RTimothyEdwards/sg13cmos5l_ocd_ip__biasgen/doc/sg13cmos5l_ocd_ip__bandgap.pdf

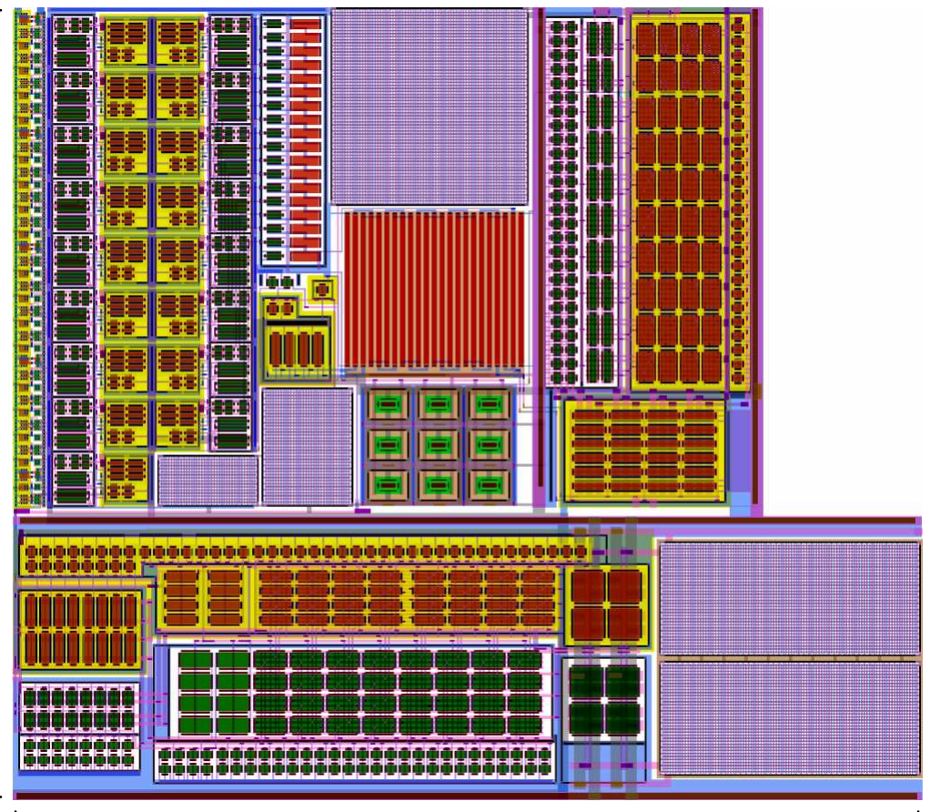
[picture p2: figure]

123µm

107µm

Circuit layout*

## sg13cmos5l_ocd_ip__bandgap

Bandgap voltage reference for IHP sg13cmos5l

Circuit description:

Pinout:
vdd
vss
dvdd
dvss
ena

vbg
trim
ibias1_250n
ibias2_1u

Analog power supply, nominally 3.3V Analog ground
Digital power supply, nominaly 1.2V Digital ground
Bandgap enable, digital (1.2V) domain
1 = enabled, 0 = disabled
Bandgap voltage output, nominally 1.2V
16−bit thermometer−encoded trim, digital (1.2V) domain. See table below
Bias current for bandgap, 250nA sink. Can be provided by the bias current generator in this repository. Bias current for output buffer, 1µA sink. Can be provided by the bias current generator in this repository.

Please note that the bias current generator circuit only stabilizes the current sources with the bandgap reference, while the current sinks are self−biased. The bandgap uses only current sinks to avoid a feedback loop with the current bias generator.

This is a standard bipolar bandgap reference circuit, with output trimmable by a 16−bit thermometer−encoded trim setting. The output is buffered by a follower amplifier.

vbg (nom.)

1.295V

1.231V

Note that this is a test version. It is based on the uncharacterized PNPMPA lateral bipolar, using the existing model from sg13g2. Once this circuit has been manufactured and tested, it will be re−trimmed to the correct nominal output.

trim trim[15:0]

1.184V0000000000000000
| 0000000000000001
| 0000000000000011
| 0000000000000111
| 0000000000001111
| 0000000000011111
| 0000000000111111
| 0000000001111111
| 0000000011111111
| 0000000111111111
| 0000001111111111
| 0000011111111111
| 0000111111111111
| 0001111111111111
| 0011111111111111
| 0111111111111111
| 1111111111111111

Also note: Future versions of this bandgap will replace the thermometer−encoded trim with a 4−bit binary trim input value.

*Note that there are different circuit layouts for the same device, with different aspect ratios.

1.188V
1.192V
1.198V
1.204V
1.211V
1.217V
1.224V

1.238V
1.246V
1.254V
1.261V
1.270V
1.278V
1.287V

Temperature coefficients
-40˚C to 125˚C: 35.78 ppm/˚C 0˚C to 85˚C: 21.58 ppm/˚C

## sg13cmos5l_ocd_ip__bandgap

Design: Theory of operation

This bandgap design was ported from a design for sky130 by Christoph Weiser. It is a standard voltage-mode bandgap reference, a variant of the Kuijk topology, with the output voltage taken directly from the drain of the pFET (feedback node).

The reference voltage is defined by

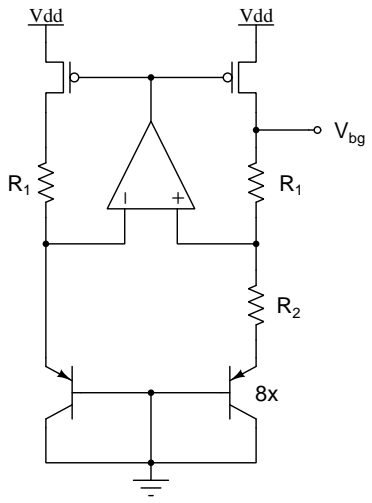
[picture p3: figure]
Vdd; Vbg

Vbg = VBE1 + (R1

/ R2

) ln(8) VT

In this layout, R1

= 394.5kΩ

The ratio of R2 to R1

is

The target current through the single bipolar is Itarget = 1.365µA By simulation, VBE1 at this current is 0.750 V.
VT at room temperature is 25.9mV.

The nominal R2

is therefore
R2

= VT

ln(8) / Itarget = 39.45kΩ

(1.25V - 0.75 V) / 53.85mV = 9.285

(Vbg - VBE1) / (VT

ln(8))

where 8 is the current ratio between the bipolars.

R2

is divided into a fixed and a variable (trimmable) component.

R2fixed = R1

/ 10 = 39.45kΩ
R2var (nominal) = (R1

/ 9.285) - R2fixed = 3.038kΩ

The variable resistance is made with a chain of 16 resistors, with each resistor shorted by a FET when the corresponding thermometer code bit is high. By simulation, the resistance of each FET is found to be 50Ω. The minimum resistance of R2var = 800Ω when all FETs are turned on and all resistors shorted. To make the centerpoint (half of the resistors shorted) be 3.038kΩ, the maximum resistance should be 5.274kΩ, and therefore each resistor should be (5,274 / 16 ≈ ) 330Ω.

Simulation shows the temperature response is flattest at approximately room temperature when the trim word is 0x00ff (half of the switches on, half off).
