RTimothyEdwards/sg13cmos5l_ocd_ip__biasgen/doc/bias_generator_fe.png

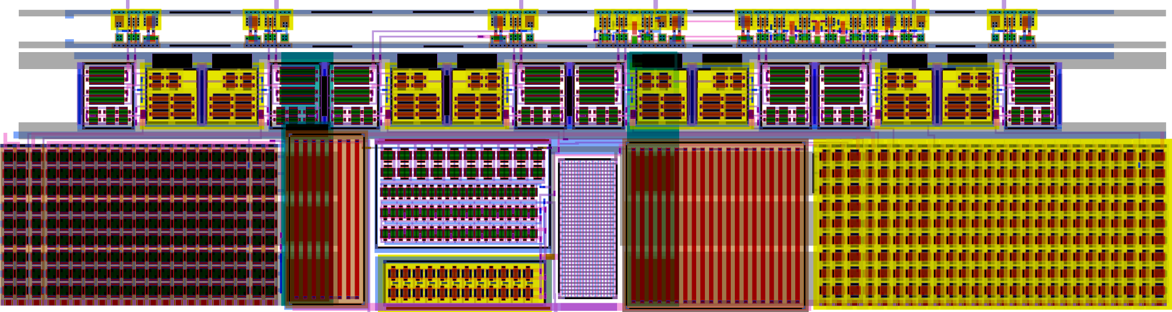
doc/bias_generator_fe.png
