RTimothyEdwards/sg13cmos5l_ocd_ip__biasgen/doc/sg13cmos5l_ocd_ip__bandgap.png

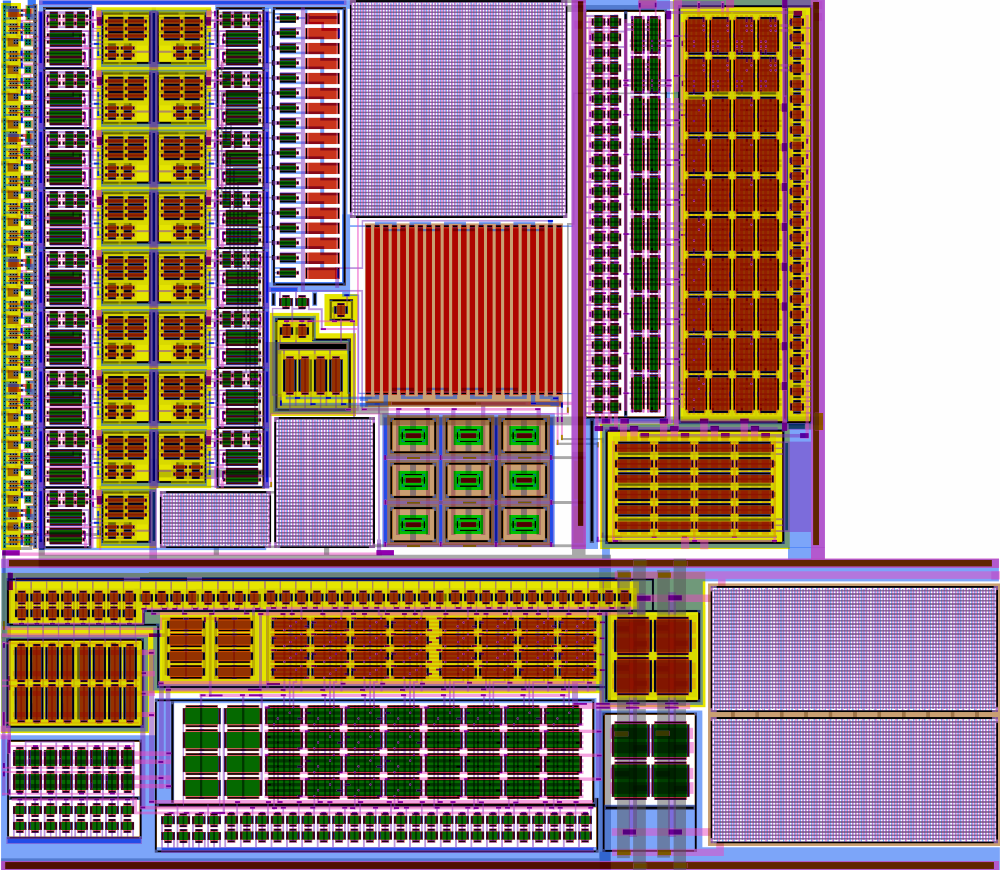
doc/sg13cmos5l_ocd_ip__bandgap.png
