RTimothyEdwards/sg13cmos5l_ocd_ip__biasgen/doc/sg13cmos5l_ocd_ip__voltgen.png

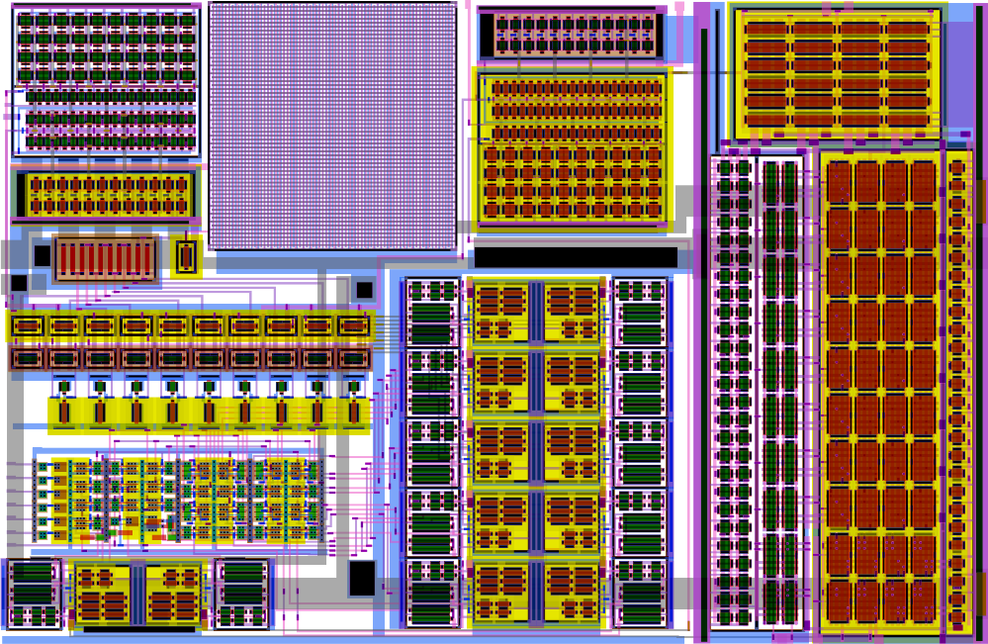
doc/sg13cmos5l_ocd_ip__voltgen.png
