RTimothyEdwards/sg13cmos5l_ocd_ip__biasgen/netlist/schematic/sg13cmos5l_ocd_ip__voltgen_v3.spice

** sch_path: /home/tim/gits/sg13cmos5l_ocd_chipalooza/dependencies/sg13cmos5l_ocd_ip__biasgen/xschem/sg13cmos5l_ocd_ip__voltgen_v3.sch
.subckt sg13cmos5l_ocd_ip__voltgen_v3 dvdd dvss vdd s[2] s[1] s[0] vbg vss ibias1u_1 vout_buf ibias1u_2 ena vout_unbuf ena1 ena2
+ high vgen_ena2_h
*.PININFO vdd:B vss:B vbg:I vout_unbuf:O ibias1u_1:B s[2:0]:I dvdd:B dvss:B ena:I vout_buf:O ibias1u_2:B ena1:I ena2:I high:I
*+ vgen_ena2_h:O
XM1 vref7 net22 vdd vdd sg13_hv_pmos w=2u l=0.5u ng=1 m=1 mm_ok=1
XR1 vref7 vref6 vss rhigh w=0.5e-6 l=2.5e-6 m=1 b=0 mm_ok=1
XR2 vref6 vref5 vss rhigh w=0.5e-6 l=2.5e-6 m=1 b=0 mm_ok=1
XR3 vref5 vref4 vss rhigh w=0.5e-6 l=2.5e-6 m=1 b=0 mm_ok=1
XR4 vref4 vref3 vss rhigh w=0.5e-6 l=2.5e-6 m=1 b=0 mm_ok=1
XR5 vref3 vref2 vss rhigh w=0.5e-6 l=2.5e-6 m=1 b=0 mm_ok=1
XR6 vref2 vref1 vss rhigh w=0.5e-6 l=2.5e-6 m=1 b=0 mm_ok=1
XR7 vref1 vref0 vss rhigh w=0.5e-6 l=2.5e-6 m=1 b=0 mm_ok=1
XR8 vref0 vss vss rhigh w=0.5e-6 l=2.5e-6 m=1 b=0 mm_ok=1
x2 v7b vdd vref7 vout_unbuf vss v7 xgate
x3 vdd v0 v0b vss hv_inv_1
x4 v6b vdd vref6 vout_unbuf vss v6 xgate
x5 v5b vdd vref5 vout_unbuf vss v5 xgate
x6 v4b vdd vref4 vout_unbuf vss v4 xgate
x7 v3b vdd vref3 vout_unbuf vss v3 xgate
x8 v2b vdd vref2 vout_unbuf vss v2 xgate
x9 v1b vdd vref1 vout_unbuf vss v1 xgate
x10 v0b vdd vref0 vout_unbuf vss v0 xgate
x11 net2 net1 v0 vdd vss level_shift
x12 net1 net2 dvdd dvss sg13cmos5l_inv_2
x13 net2 s2b s1b s0b dvdd dvss sg13cmos5l_nand3_1
x14 s0b s[0] dvdd dvss sg13cmos5l_inv_2
x15 s1b s[1] dvdd dvss sg13cmos5l_inv_2
x16 s2b s[2] dvdd dvss sg13cmos5l_inv_2
x17 s0 s0b dvdd dvss sg13cmos5l_inv_2
x18 s1 s1b dvdd dvss sg13cmos5l_inv_2
x19 s2 s2b dvdd dvss sg13cmos5l_inv_2
x20 vdd v1 v1b vss hv_inv_1
x21 net4 net3 v1 vdd vss level_shift
x22 net3 net4 dvdd dvss sg13cmos5l_inv_2
x23 net4 s2b s1b s0 dvdd dvss sg13cmos5l_nand3_1
x24 vdd v2 v2b vss hv_inv_1
x25 net6 net5 v2 vdd vss level_shift
x26 net5 net6 dvdd dvss sg13cmos5l_inv_2
x27 net6 s2b s1 s0b dvdd dvss sg13cmos5l_nand3_1
x28 vdd v3 v3b vss hv_inv_1
x29 net8 net7 v3 vdd vss level_shift
x30 net7 net8 dvdd dvss sg13cmos5l_inv_2
x31 net8 s2b s1 s0 dvdd dvss sg13cmos5l_nand3_1
x32 vdd v4 v4b vss hv_inv_1
x33 net10 net9 v4 vdd vss level_shift
x34 net9 net10 dvdd dvss sg13cmos5l_inv_2
x35 net10 s2 s1b s0b dvdd dvss sg13cmos5l_nand3_1
x36 vdd v5 v5b vss hv_inv_1
x37 net12 net11 v5 vdd vss level_shift
x38 net11 net12 dvdd dvss sg13cmos5l_inv_2
x39 net12 s2 s1b s0 dvdd dvss sg13cmos5l_nand3_1
x40 vdd v6 v6b vss hv_inv_1
x41 net14 net13 v6 vdd vss level_shift
x42 net13 net14 dvdd dvss sg13cmos5l_inv_2
x43 net14 s2 s1 s0b dvdd dvss sg13cmos5l_nand3_1
x44 vdd v7 v7b vss hv_inv_1
x45 net16 net15 v7 vdd vss level_shift
x46 net15 net16 dvdd dvss sg13cmos5l_inv_2
x47 net16 s2 s1 s0 dvdd dvss sg13cmos5l_nand3_1
x1 net18 ena vgen_ena_h vdd vss level_shift
x51 net18 ena dvdd dvss sg13cmos5l_inv_2
x48 vdd net22 vbg net17 ibias1u_1 vss vgen_ena_h n_amp_large
x52 vdd vout_buf vout_unbuf vout_buf vss ibias1u_2 vgen_ena1_h se_folded_cascode_p
x49 net19 ena1 vgen_ena1_h vdd vss level_shift
x53 net19 ena1 dvdd dvss sg13cmos5l_inv_2
x54 net20 ena2 vgen_ena2_h vdd vss level_shift
x55 net20 ena2 dvdd dvss sg13cmos5l_inv_2
x56 high_h vdd net17 vref3 vss low_h xgate
x57 low_h vdd net17 vref2 vss high_h xgate
x58 net21 high high_h vdd vss level_shift
x59 net21 high dvdd dvss sg13cmos5l_inv_2
x60 vdd high_h low_h vss hv_inv_1
XR9 vss vss vss rhigh w=0.5e-6 l=2.5e-6 m=1 b=0 mm_ok=1
XR10 vss vss vss rhigh w=0.5e-6 l=2.5e-6 m=1 b=0 mm_ok=1
x67 s[0] dvdd dvss sg13cmos5l_antennanp
x68 dvdd dvss sg13cmos5l_decap_4
x61 s[1] dvdd dvss sg13cmos5l_antennanp
x62 s[2] dvdd dvss sg13cmos5l_antennanp
x63 high dvdd dvss sg13cmos5l_antennanp
x64 ena dvdd dvss sg13cmos5l_antennanp
x65 ena1 dvdd dvss sg13cmos5l_antennanp
x66 ena2 dvdd dvss sg13cmos5l_antennanp
XC4 vdd net22 cap_cmomf w=15e-6 l=23e-6 mmin=1 mmax=4 subblock=0 m=1 mm_ok=1
XC5 vdd net22 cap_cmomf w=26.26e-6 l=26.26e-6 mmin=1 mmax=4 subblock=0 m=1 mm_ok=1
XC6 vdd net22 cap_cmomf w=8e-6 l=23e-6 mmin=1 mmax=4 subblock=0 m=1 mm_ok=1
.ends

* expanding   symbol:  xgate.sym # of pins=6
** sym_path: /home/tim/gits/sg13cmos5l_ocd_chipalooza/dependencies/sg13cmos5l_ocd_ip__biasgen/xschem/xgate.sym
** sch_path: /home/tim/gits/sg13cmos5l_ocd_chipalooza/dependencies/sg13cmos5l_ocd_ip__biasgen/xschem/xgate.sch
.subckt xgate ena_b vdd in out vss ena
*.PININFO out:B in:B vdd:B vss:B ena_b:I ena:I
XM1 in ena_b out vdd sg13_hv_pmos w=2u l=0.5u ng=1 m=1 mm_ok=1
XM2 in ena out vss sg13_hv_nmos w=2u l=0.5u ng=1 m=1 mm_ok=1
.ends


* expanding   symbol:  hv_inv_1.sym # of pins=4
** sym_path: /home/tim/gits/sg13cmos5l_ocd_chipalooza/dependencies/sg13cmos5l_ocd_ip__biasgen/xschem/hv_inv_1.sym
** sch_path: /home/tim/gits/sg13cmos5l_ocd_chipalooza/dependencies/sg13cmos5l_ocd_ip__biasgen/xschem/hv_inv_1.sch
.subckt hv_inv_1 vdd A X vss
*.PININFO A:I vdd:B vss:B X:O
XM1 X A vdd vdd sg13_hv_pmos w=2.0u l=0.4u ng=1 m=1 mm_ok=1
XM2 X A vss vss sg13_hv_nmos w=1.0u l=0.45u ng=1 m=1 mm_ok=1
.ends


* expanding   symbol:  level_shift.sym # of pins=3
** sym_path: /home/tim/gits/sg13cmos5l_ocd_chipalooza/dependencies/sg13cmos5l_ocd_ip__biasgen/xschem/level_shift.sym
** sch_path: /home/tim/gits/sg13cmos5l_ocd_chipalooza/dependencies/sg13cmos5l_ocd_ip__biasgen/xschem/level_shift.sch
.subckt level_shift in_n in_p out vdd vss
*.PININFO in_n:I in_p:I out:O
XM1 net1 in_p vss vss sg13_hv_nmos w=4u l=0.5u ng=1 m=2 mm_ok=1
XM2 net1 S1_N vdd vdd sg13_hv_pmos w=1u l=0.5u ng=1 m=2 mm_ok=1
XM3 S1_N in_n vss vss sg13_hv_nmos w=4u l=0.5u ng=1 m=2 mm_ok=1
XM4 S1_N net1 vdd vdd sg13_hv_pmos w=1u l=0.5u ng=1 m=2 mm_ok=1
XM5 S2_N S1_N vdd vdd sg13_hv_pmos w=2u l=0.5u ng=1 m=2 mm_ok=1
XM6 S2_N S1_N vss vss sg13_hv_nmos w=1u l=0.5u ng=1 m=2 mm_ok=1
XM7 out S2_N vdd vdd sg13_hv_pmos w=2u l=0.5u ng=1 m=4 mm_ok=1
XM8 out S2_N vss vss sg13_hv_nmos w=1u l=0.5u ng=1 m=4 mm_ok=1
.ends


* expanding   symbol:  n_amp_large.sym # of pins=7
** sym_path: /home/tim/gits/sg13cmos5l_ocd_chipalooza/dependencies/sg13cmos5l_ocd_ip__biasgen/xschem/n_amp_large.sym
** sch_path: /home/tim/gits/sg13cmos5l_ocd_chipalooza/dependencies/sg13cmos5l_ocd_ip__biasgen/xschem/n_amp_large.sch
.subckt n_amp_large avdd out inn inp ibias avss ena
*.PININFO inp:I inn:I out:O avdd:B avss:B ena:I ibias:B
XM1 vcom net1 avss avss sg13_hv_nmos w=20u l=1u ng=20 m=1 mm_ok=1
XM2 out outn avdd avdd sg13_hv_pmos w=10u l=0.5u ng=10 m=1 mm_ok=1
XM3 outn outn avdd avdd sg13_hv_pmos w=10u l=0.5u ng=10 m=1 mm_ok=1
XM4 outn inp vcom avss sg13_hv_nmos w=20u l=0.5u ng=20 m=1 mm_ok=1
XM5 out inn vcom avss sg13_hv_nmos w=20u l=0.5u ng=20 m=1 mm_ok=1
XM6 ibias ena net1 avss sg13_hv_nmos w=20u l=0.5u ng=20 m=1 mm_ok=1
XM7 net1 net1 avss avss sg13_hv_nmos w=20u l=1u ng=20 m=1 mm_ok=1
XM8 avdd avdd avdd avdd sg13_hv_pmos w=2u l=0.5u ng=2 m=2 mm_ok=1
.ends


* expanding   symbol:  se_folded_cascode_p.sym # of pins=7
** sym_path: /home/tim/gits/sg13cmos5l_ocd_chipalooza/dependencies/sg13cmos5l_ocd_ip__biasgen/xschem/se_folded_cascode_p.sym
** sch_path: /home/tim/gits/sg13cmos5l_ocd_chipalooza/dependencies/sg13cmos5l_ocd_ip__biasgen/xschem/se_folded_cascode_p.sch
.subckt se_folded_cascode_p vdd out inp inn vss bias ena
*.PININFO inn:I inp:I out:O bias:B vdd:B vss:B ena:I
XM3 out1p inn diff vdd sg13_hv_pmos w=4u l=1u ng=1 m=8 mm_ok=1
XM2 out1n inp diff vdd sg13_hv_pmos w=4u l=1u ng=1 m=8 mm_ok=1
XM1 diff vbp1 vdd vdd sg13_hv_pmos w=1u l=1u ng=1 m=16 mm_ok=1
XM4 out1n vbn1 vss vss sg13_hv_nmos w=1u l=1u ng=1 m=16 mm_ok=1
XM5 out1p vbn1 vss vss sg13_hv_nmos w=1u l=1u ng=1 m=16 mm_ok=1
XM6 mirr vbn2 out1n vss sg13_hv_nmos w=1u l=4u ng=1 m=8 mm_ok=1
XM7 out vbn2 out1p vss sg13_hv_nmos w=1u l=4u ng=1 m=8 mm_ok=1
XM8 mirr bias nd10 vdd sg13_hv_pmos w=2u l=4u ng=1 m=8 mm_ok=1
XM9 out bias nd11 vdd sg13_hv_pmos w=2u l=4u ng=1 m=8 mm_ok=1
XM10 nd10 mirr vdd vdd sg13_hv_pmos w=2u l=4u ng=1 m=8 mm_ok=1
XM11 nd11 mirr vdd vdd sg13_hv_pmos w=2u l=4u ng=1 m=8 mm_ok=1
XMB1 bias bias vbp1 vdd sg13_hv_pmos w=2u l=4u ng=1 m=4 mm_ok=1
XMB2 vbp1 vbp1 vdd vdd sg13_hv_pmos w=1u l=1u ng=1 m=4 mm_ok=1
XMB3 vbn2 vbp1 vdd vdd sg13_hv_pmos w=1u l=1u ng=1 m=4 mm_ok=1
XMB4 vbn2 vbn2 vbn1 vss sg13_hv_nmos w=1u l=4u ng=1 m=4 mm_ok=1
XMB5 vbn1 vbn1 vss vss sg13_hv_nmos w=1u l=1u ng=1 m=4 mm_ok=1
XMB6 bias ena vdd vdd sg13_hv_pmos w=1u l=1u ng=1 m=1 mm_ok=1
XM12 vdd vdd vdd vdd sg13_hv_pmos w=4u l=1u ng=1 m=8 mm_ok=1
XM13 vdd vdd vdd vdd sg13_hv_pmos w=1u l=1u ng=1 m=1 mm_ok=1
XMB7 vss vss vss vss sg13_hv_nmos w=1u l=1u ng=1 m=16 mm_ok=1
XMB8 vdd vdd vdd vdd sg13_hv_pmos w=2u l=4u ng=1 m=4 mm_ok=1
.ends
