RTimothyEdwards/sg13cmos5l_ocd_ip__biasgen/netlist/schematic/sg13cmos5l_ocd_ip__biasgen1.spice

** sch_path: /home/tim/gits/sg13cmos5l_ocd_chipalooza/dependencies/sg13cmos5l_ocd_ip__biasgen/xschem/sg13cmos5l_ocd_ip__biasgen1.sch
.subckt sg13cmos5l_ocd_ip__biasgen1 ena avdd avss ref_in dvdd vbg ref_sel_vbg dvss bandgap_source_ibias bandgap_source[4]
+ bandgap_source[3] bandgap_source[2] bandgap_source[1] bandgap_source[0] bandgap_sink[4] bandgap_sink[3] bandgap_sink[2] bandgap_sink[1]
+ bandgap_sink[0] voltgen_source1[4] voltgen_source1[3] voltgen_source1[2] voltgen_source1[1] voltgen_source1[0] bandgap_sink_ibias
+ voltgen_source2[4] voltgen_source2[3] voltgen_source2[2] voltgen_source2[1] voltgen_source2[0] voltgen_sink[4] voltgen_sink[3] voltgen_sink[2]
+ voltgen_sink[1] voltgen_sink[0] voltgen_source1_ibias test_sink[4] test_sink[3] test_sink[2] test_sink[1] test_sink[0] voltgen_source2_ibias
+ idac1_source[7] idac1_source[6] idac1_source[5] idac1_source[4] idac1_source[3] idac1_source[2] idac1_source[1] idac1_source[0]
+ voltgen_sink_ibias test_sink_ibias idac1_source idac2_source idac1_sink[7] idac1_sink[6] idac1_sink[5] idac1_sink[4] idac1_sink[3] idac1_sink[2]
+ idac1_sink[1] idac1_sink[0] idac2_source[7] idac2_source[6] idac2_source[5] idac2_source[4] idac2_source[3] idac2_source[2] idac2_source[1]
+ idac2_source[0] idac2_sink[7] idac2_sink[6] idac2_sink[5] idac2_sink[4] idac2_sink[3] idac2_sink[2] idac2_sink[1] idac2_sink[0] idac1_sink
+ idac2_sink ref_sel_coarse ref_sel_fine
*.PININFO avdd:B avss:B dvdd:B dvss:B ena:I ref_in:I vbg:I ref_sel_vbg:I bandgap_sink[4:0]:I voltgen_sink[4:0]:I test_sink[4:0]:I
*+ idac1_sink[7:0]:I idac2_sink[7:0]:I bandgap_sink_ibias:B voltgen_sink_ibias:B test_sink_ibias:B idac1_sink:B idac2_sink:B ref_sel_fine:I
*+ ref_sel_coarse:I bandgap_source_ibias:B voltgen_source1_ibias:B voltgen_source2_ibias:B idac1_source:B idac2_source:B bandgap_source[4:0]:I
*+ voltgen_source1[4:0]:I voltgen_source2[4:0]:I idac1_source[7:0]:I idac2_source[7:0]:I
x1 avdd ena vbg net1 avss dvdd dvss ref_sel_vbg ref_in dvss nbias pcasc pbias net2 dvss ncasc ref_sel_fine ref_sel_coarse avdd
+ bias_generator_fe
* noconn #net1
* noconn #net2
x12 dvdd dvss avdd nbias avss bandgap_sink[4] bandgap_sink[3] bandgap_sink[2] bandgap_sink[1] bandgap_sink[0] bandgap_sink_ibias
+ ncasc avss avss bias_generator_be0n
x13 dvdd dvss avdd pcasc pbias bandgap_source[4] bandgap_source[3] bandgap_source[2] bandgap_source[1] bandgap_source[0]
+ bandgap_source_ibias avss avdd avdd avdd bias_generator_be0p
x14 dvdd dvss avdd nbias avss idac1_sink[7] idac1_sink[6] idac1_sink[5] idac1_sink[4] idac1_sink[3] idac1_sink[2] idac1_sink[1]
+ idac1_sink[0] idac1_sink ncasc avss avss bias_generator_be1n
x15 dvdd dvss avdd pcasc pbias idac2_source[7] idac2_source[6] idac2_source[5] idac2_source[4] idac2_source[3] idac2_source[2]
+ idac2_source[1] idac2_source[0] idac2_source avss avdd avdd avdd bias_generator_be1p
x2 dvdd dvss avdd nbias avss voltgen_sink[4] voltgen_sink[3] voltgen_sink[2] voltgen_sink[1] voltgen_sink[0] voltgen_sink_ibias
+ ncasc avss avss bias_generator_be0n
x4 dvdd dvss avdd nbias avss test_sink[4] test_sink[3] test_sink[2] test_sink[1] test_sink[0] test_sink_ibias ncasc avss avss
+ bias_generator_be0n
x3 dvdd dvss avdd nbias avss idac2_sink[7] idac2_sink[6] idac2_sink[5] idac2_sink[4] idac2_sink[3] idac2_sink[2] idac2_sink[1]
+ idac2_sink[0] idac2_sink ncasc avss avss bias_generator_be1n
x5 dvdd dvss avdd pcasc pbias voltgen_source1[4] voltgen_source1[3] voltgen_source1[2] voltgen_source1[1] voltgen_source1[0]
+ voltgen_source1_ibias avss avdd avdd avdd bias_generator_be0p
x6 dvdd dvss avdd pcasc pbias voltgen_source2[4] voltgen_source2[3] voltgen_source2[2] voltgen_source2[1] voltgen_source2[0]
+ voltgen_source2_ibias avss avdd avdd avdd bias_generator_be0p
x7 dvdd dvss avdd pcasc pbias idac1_source[7] idac1_source[6] idac1_source[5] idac1_source[4] idac1_source[3] idac1_source[2]
+ idac1_source[1] idac1_source[0] idac1_source avss avdd avdd avdd bias_generator_be1p
x8[11] net4 avss ncasc nbias avss avss avss bias_nstack
x8[10] net4 avss ncasc nbias avss avss avss bias_nstack
x8[9] net4 avss ncasc nbias avss avss avss bias_nstack
x8[8] net4 avss ncasc nbias avss avss avss bias_nstack
x8[7] net4 avss ncasc nbias avss avss avss bias_nstack
x8[6] net4 avss ncasc nbias avss avss avss bias_nstack
x8[5] net4 avss ncasc nbias avss avss avss bias_nstack
x8[4] net4 avss ncasc nbias avss avss avss bias_nstack
x8[3] net4 avss ncasc nbias avss avss avss bias_nstack
x8[2] net4 avss ncasc nbias avss avss avss bias_nstack
x8[1] net4 avss ncasc nbias avss avss avss bias_nstack
x8[0] net4 avss ncasc nbias avss avss avss bias_nstack
x9[11] avdd pbias pcasc avdd net3 avdd avdd bias_pstack
x9[10] avdd pbias pcasc avdd net3 avdd avdd bias_pstack
x9[9] avdd pbias pcasc avdd net3 avdd avdd bias_pstack
x9[8] avdd pbias pcasc avdd net3 avdd avdd bias_pstack
x9[7] avdd pbias pcasc avdd net3 avdd avdd bias_pstack
x9[6] avdd pbias pcasc avdd net3 avdd avdd bias_pstack
x9[5] avdd pbias pcasc avdd net3 avdd avdd bias_pstack
x9[4] avdd pbias pcasc avdd net3 avdd avdd bias_pstack
x9[3] avdd pbias pcasc avdd net3 avdd avdd bias_pstack
x9[2] avdd pbias pcasc avdd net3 avdd avdd bias_pstack
x9[1] avdd pbias pcasc avdd net3 avdd avdd bias_pstack
x9[0] avdd pbias pcasc avdd net3 avdd avdd bias_pstack
* noconn #net4
* noconn #net3
.ends

* expanding   symbol:  bias_generator_fe.sym # of pins=19
** sym_path: /home/tim/gits/sg13cmos5l_ocd_chipalooza/dependencies/sg13cmos5l_ocd_ip__biasgen/xschem/bias_generator_fe.sym
** sch_path: /home/tim/gits/sg13cmos5l_ocd_chipalooza/dependencies/sg13cmos5l_ocd_ip__biasgen/xschem/bias_generator_fe.sch
.subckt bias_generator_fe avdd ena vbg src_test0 avss dvdd ena_src_test0 ref_sel_vbg ref_in dvss nbias pcasc pbias snk_test0
+ ena_snk_test0 ncasc ref_sel_fine ref_sel_coarse shld2
*.PININFO ref_in:I avss:B ref_sel_vbg:I avdd:B ena_src_test0:I ena_snk_test0:I src_test0:B snk_test0:B vbg:I ena:I dvdd:B dvss:B
*+ pcasc:O pbias:O nbias:O ncasc:O ref_sel_fine:I ref_sel_coarse:I shld2:B
XR4 ref_in net7 avss rhigh w=0.5u l=138.57u m=1 b=0 mm_ok=1
x4 net1 ena_3v3 ncasc nbias avss avss avss bias_nstack
x13[1] avdd pbias pcasc enb_test0_3v3 src_test0 shld2 avdd bias_pstack
x13[0] avdd pbias pcasc enb_test0_3v3 src_test0 shld2 avdd bias_pstack
x17[1] snk_test0 ena_test0_3v3 ncasc nbias avss avss avss bias_nstack
x17[0] snk_test0 ena_test0_3v3 ncasc nbias avss avss avss bias_nstack
x1 ref_sel_vbg net2 enb_vbg_3v3 avdd avss level_shift
x11 net5 ena_snk_test0 ena_test0_3v3 avdd avss level_shift
x23 ena_src_test0 net4 enb_test0_3v3 avdd avss level_shift
x24 net3 ena dvdd dvss sg13cmos5l_inv_2
x35 net2 ref_sel_vbg dvdd dvss sg13cmos5l_inv_2
XR1 net10 avss avss rhigh w=0.5u l=337.14u m=1 b=0 mm_ok=1
x36 net3 ena ena_3v3 avdd avss level_shift
Vmeas vfb net10 0
.save i(vmeas)
x19[2] avdd pbias pcasc enb_std_3v3 vfb shld2 avdd bias_pstack
x19[1] avdd pbias pcasc enb_std_3v3 vfb shld2 avdd bias_pstack
x19[0] avdd pbias pcasc enb_std_3v3 vfb shld2 avdd bias_pstack
x5[6] dvdd dvss sg13cmos5l_decap_4
x5[5] dvdd dvss sg13cmos5l_decap_4
x5[4] dvdd dvss sg13cmos5l_decap_4
x5[3] dvdd dvss sg13cmos5l_decap_4
x5[2] dvdd dvss sg13cmos5l_decap_4
x5[1] dvdd dvss sg13cmos5l_decap_4
x5[0] dvdd dvss sg13cmos5l_decap_4
x5 ref_sel_vbg dvdd dvss sg13cmos5l_antennanp
x6 ena dvdd dvss sg13cmos5l_antennanp
x7 ena_src_test0 dvdd dvss sg13cmos5l_antennanp
x8 ena_snk_test0 dvdd dvss sg13cmos5l_antennanp
x9 net4 ena_src_test0 dvdd dvss sg13cmos5l_inv_2
x10 net5 ena_snk_test0 dvdd dvss sg13cmos5l_inv_2
x12 net2 ref_sel_vbg ena_vbg_3v3 avdd avss level_shift
x1[15] nset ena_3v3 ncasc nbias avss avss avss bias_nset
x1[14] nset ena_3v3 ncasc nbias avss avss avss bias_nset
x1[13] nset ena_3v3 ncasc nbias avss avss avss bias_nset
x1[12] nset ena_3v3 ncasc nbias avss avss avss bias_nset
x1[11] nset ena_3v3 ncasc nbias avss avss avss bias_nset
x1[10] nset ena_3v3 ncasc nbias avss avss avss bias_nset
x1[9] nset ena_3v3 ncasc nbias avss avss avss bias_nset
x1[8] nset ena_3v3 ncasc nbias avss avss avss bias_nset
x1[7] nset ena_3v3 ncasc nbias avss avss avss bias_nset
x1[6] nset ena_3v3 ncasc nbias avss avss avss bias_nset
x1[5] nset ena_3v3 ncasc nbias avss avss avss bias_nset
x1[4] nset ena_3v3 ncasc nbias avss avss avss bias_nset
x1[3] nset ena_3v3 ncasc nbias avss avss avss bias_nset
x1[2] nset ena_3v3 ncasc nbias avss avss avss bias_nset
x1[1] nset ena_3v3 ncasc nbias avss avss avss bias_nset
x1[0] nset ena_3v3 ncasc nbias avss avss avss bias_nset
x14 avdd pbias pcasc ena_vbg_3v3 net6 avdd bias_pset
Vmeas1 net7 nset 0
.save i(vmeas1)
Vmeas2 net6 net1 0
.save i(vmeas2)
x3 avdd pbias vbg vfb nbias avss ena_vbg_3v3 bias_amp_large
x2[15] avdd pbias pcasc enb_fine_3v3 vfb shld2 avdd bias_pstack
x2[14] avdd pbias pcasc enb_fine_3v3 vfb shld2 avdd bias_pstack
x2[13] avdd pbias pcasc enb_fine_3v3 vfb shld2 avdd bias_pstack
x2[12] avdd pbias pcasc enb_fine_3v3 vfb shld2 avdd bias_pstack
x2[11] avdd pbias pcasc enb_fine_3v3 vfb shld2 avdd bias_pstack
x2[10] avdd pbias pcasc enb_fine_3v3 vfb shld2 avdd bias_pstack
x2[9] avdd pbias pcasc enb_fine_3v3 vfb shld2 avdd bias_pstack
x2[8] avdd pbias pcasc enb_fine_3v3 vfb shld2 avdd bias_pstack
x2[7] avdd pbias pcasc enb_fine_3v3 vfb shld2 avdd bias_pstack
x2[6] avdd pbias pcasc enb_fine_3v3 vfb shld2 avdd bias_pstack
x2[5] avdd pbias pcasc enb_fine_3v3 vfb shld2 avdd bias_pstack
x2[4] avdd pbias pcasc enb_fine_3v3 vfb shld2 avdd bias_pstack
x2[3] avdd pbias pcasc enb_fine_3v3 vfb shld2 avdd bias_pstack
x2[2] avdd pbias pcasc enb_fine_3v3 vfb shld2 avdd bias_pstack
x2[1] avdd pbias pcasc enb_fine_3v3 vfb shld2 avdd bias_pstack
x2[0] avdd pbias pcasc enb_fine_3v3 vfb shld2 avdd bias_pstack
x15 net9 net8 enb_fine_3v3 avdd avss level_shift
x16 net9 net8 dvdd dvss sg13cmos5l_inv_2
x17 net15 ref_sel_coarse ref_sel_fine dvdd dvss sg13cmos5l_nand2_1
x13 avdd pbias pcasc enb_coarse_3v3 vfb shld2 avdd bias_pstack
x18 net16 ref_sel_coarse net18 dvdd dvss sg13cmos5l_nor2_1
x19 net12 net11 enb_coarse_3v3 avdd avss level_shift
x20 net12 net11 dvdd dvss sg13cmos5l_inv_2
x21 net14 net13 enb_std_3v3 avdd avss level_shift
x22 net14 net13 dvdd dvss sg13cmos5l_inv_2
x25 net11 net15 ref_sel_vbg dvdd dvss sg13cmos5l_nand2_1
x26 net8 net16 ref_sel_vbg dvdd dvss sg13cmos5l_nand2_1
x27 net13 net17 ref_sel_vbg dvdd dvss sg13cmos5l_nand2_1
x29 net18 ref_sel_fine dvdd dvss sg13cmos5l_inv_2
x28 net17 net18 ref_sel_coarse dvdd dvss sg13cmos5l_nand2_1
x30 avdd dummypbias pcasc enb_vbg_3v3 net6 pbias avdd bias_pset2
x2 ref_sel_coarse dvdd dvss sg13cmos5l_antennanp
x31 ref_sel_fine dvdd dvss sg13cmos5l_antennanp
x4[1] avdd dummypbias pcasc avdd vfb pbias avdd bias_pstack
x4[0] avdd dummypbias pcasc avdd vfb pbias avdd bias_pstack
x3[1] nset avss ncasc nbias avss avss avss bias_nstack
x3[0] nset avss ncasc nbias avss avss avss bias_nstack
XC1 pbias vfb cap_cmomf w=6.75e-6 l=16e-6 mmin=1 mmax=4 subblock=0 m=1 mm_ok=1
.ends


* expanding   symbol:  bias_generator_be0n.sym # of pins=10
** sym_path: /home/tim/gits/sg13cmos5l_ocd_chipalooza/dependencies/sg13cmos5l_ocd_ip__biasgen/xschem/bias_generator_be0n.sym
** sch_path: /home/tim/gits/sg13cmos5l_ocd_chipalooza/dependencies/sg13cmos5l_ocd_ip__biasgen/xschem/bias_generator_be0n.sch
.subckt bias_generator_be0n dvdd dvss avdd nbias avss sink_ena[4] sink_ena[3] sink_ena[2] sink_ena[1] sink_ena[0] sink_ibias ncasc
+ shld2 shld3
*.PININFO avss:B avdd:B dvdd:B dvss:B nbias:I ncasc:I sink_ibias:B sink_ena[4:0]:I shld2:B shld3:B
x23[4] dvdd dvss sg13cmos5l_decap_4
x23[3] dvdd dvss sg13cmos5l_decap_4
x23[2] dvdd dvss sg13cmos5l_decap_4
x23[1] dvdd dvss sg13cmos5l_decap_4
x23[0] dvdd dvss sg13cmos5l_decap_4
x79[4] sink_ena[4] dvdd dvss sg13cmos5l_antennanp
x79[3] sink_ena[3] dvdd dvss sg13cmos5l_antennanp
x79[2] sink_ena[2] dvdd dvss sg13cmos5l_antennanp
x79[1] sink_ena[1] dvdd dvss sg13cmos5l_antennanp
x79[0] sink_ena[0] dvdd dvss sg13cmos5l_antennanp
x1 sink_ibias sink_ena_3v3[0] ncasc nbias avss shld2 shld3 bias_nstack
x6[1] sink_ibias sink_ena_3v3[1] ncasc nbias avss shld2 shld3 bias_nstack
x6[0] sink_ibias sink_ena_3v3[1] ncasc nbias avss shld2 shld3 bias_nstack
x7[3] sink_ibias sink_ena_3v3[2] ncasc nbias avss shld2 shld3 bias_nstack
x7[2] sink_ibias sink_ena_3v3[2] ncasc nbias avss shld2 shld3 bias_nstack
x7[1] sink_ibias sink_ena_3v3[2] ncasc nbias avss shld2 shld3 bias_nstack
x7[0] sink_ibias sink_ena_3v3[2] ncasc nbias avss shld2 shld3 bias_nstack
x8[7] sink_ibias sink_ena_3v3[3] ncasc nbias avss shld2 shld3 bias_nstack
x8[6] sink_ibias sink_ena_3v3[3] ncasc nbias avss shld2 shld3 bias_nstack
x8[5] sink_ibias sink_ena_3v3[3] ncasc nbias avss shld2 shld3 bias_nstack
x8[4] sink_ibias sink_ena_3v3[3] ncasc nbias avss shld2 shld3 bias_nstack
x8[3] sink_ibias sink_ena_3v3[3] ncasc nbias avss shld2 shld3 bias_nstack
x8[2] sink_ibias sink_ena_3v3[3] ncasc nbias avss shld2 shld3 bias_nstack
x8[1] sink_ibias sink_ena_3v3[3] ncasc nbias avss shld2 shld3 bias_nstack
x8[0] sink_ibias sink_ena_3v3[3] ncasc nbias avss shld2 shld3 bias_nstack
x11[15] sink_ibias sink_ena_3v3[4] ncasc nbias avss shld2 shld3 bias_nstack
x11[14] sink_ibias sink_ena_3v3[4] ncasc nbias avss shld2 shld3 bias_nstack
x11[13] sink_ibias sink_ena_3v3[4] ncasc nbias avss shld2 shld3 bias_nstack
x11[12] sink_ibias sink_ena_3v3[4] ncasc nbias avss shld2 shld3 bias_nstack
x11[11] sink_ibias sink_ena_3v3[4] ncasc nbias avss shld2 shld3 bias_nstack
x11[10] sink_ibias sink_ena_3v3[4] ncasc nbias avss shld2 shld3 bias_nstack
x11[9] sink_ibias sink_ena_3v3[4] ncasc nbias avss shld2 shld3 bias_nstack
x11[8] sink_ibias sink_ena_3v3[4] ncasc nbias avss shld2 shld3 bias_nstack
x11[7] sink_ibias sink_ena_3v3[4] ncasc nbias avss shld2 shld3 bias_nstack
x11[6] sink_ibias sink_ena_3v3[4] ncasc nbias avss shld2 shld3 bias_nstack
x11[5] sink_ibias sink_ena_3v3[4] ncasc nbias avss shld2 shld3 bias_nstack
x11[4] sink_ibias sink_ena_3v3[4] ncasc nbias avss shld2 shld3 bias_nstack
x11[3] sink_ibias sink_ena_3v3[4] ncasc nbias avss shld2 shld3 bias_nstack
x11[2] sink_ibias sink_ena_3v3[4] ncasc nbias avss shld2 shld3 bias_nstack
x11[1] sink_ibias sink_ena_3v3[4] ncasc nbias avss shld2 shld3 bias_nstack
x11[0] sink_ibias sink_ena_3v3[4] ncasc nbias avss shld2 shld3 bias_nstack
x4[4] net1[4] sink_ena[4] sink_ena_3v3[4] avdd avss level_shift
x4[3] net1[3] sink_ena[3] sink_ena_3v3[3] avdd avss level_shift
x4[2] net1[2] sink_ena[2] sink_ena_3v3[2] avdd avss level_shift
x4[1] net1[1] sink_ena[1] sink_ena_3v3[1] avdd avss level_shift
x4[0] net1[0] sink_ena[0] sink_ena_3v3[0] avdd avss level_shift
x5[4] net1[4] sink_ena[4] dvdd dvss sg13cmos5l_inv_2
x5[3] net1[3] sink_ena[3] dvdd dvss sg13cmos5l_inv_2
x5[2] net1[2] sink_ena[2] dvdd dvss sg13cmos5l_inv_2
x5[1] net1[1] sink_ena[1] dvdd dvss sg13cmos5l_inv_2
x5[0] net1[0] sink_ena[0] dvdd dvss sg13cmos5l_inv_2
.ends


* expanding   symbol:  bias_generator_be0p.sym # of pins=11
** sym_path: /home/tim/gits/sg13cmos5l_ocd_chipalooza/dependencies/sg13cmos5l_ocd_ip__biasgen/xschem/bias_generator_be0p.sym
** sch_path: /home/tim/gits/sg13cmos5l_ocd_chipalooza/dependencies/sg13cmos5l_ocd_ip__biasgen/xschem/bias_generator_be0p.sch
.subckt bias_generator_be0p dvdd dvss avdd pcasc pbias source_ena[4] source_ena[3] source_ena[2] source_ena[1] source_ena[0]
+ source_ibias avss shld2 shld3 shld_vdd
*.PININFO avss:B avdd:B dvdd:B dvss:B pcasc:I pbias:I source_ena[4:0]:I source_ibias:B shld2:B shld3:B shld_vdd:B
x9[4] source_ena[4] net1[4] source_ena_b_3v3[4] avdd avss level_shift
x9[3] source_ena[3] net1[3] source_ena_b_3v3[3] avdd avss level_shift
x9[2] source_ena[2] net1[2] source_ena_b_3v3[2] avdd avss level_shift
x9[1] source_ena[1] net1[1] source_ena_b_3v3[1] avdd avss level_shift
x9[0] source_ena[0] net1[0] source_ena_b_3v3[0] avdd avss level_shift
x46[4] net1[4] source_ena[4] dvdd dvss sg13cmos5l_inv_2
x46[3] net1[3] source_ena[3] dvdd dvss sg13cmos5l_inv_2
x46[2] net1[2] source_ena[2] dvdd dvss sg13cmos5l_inv_2
x46[1] net1[1] source_ena[1] dvdd dvss sg13cmos5l_inv_2
x46[0] net1[0] source_ena[0] dvdd dvss sg13cmos5l_inv_2
x23[4] dvdd dvss sg13cmos5l_decap_4
x23[3] dvdd dvss sg13cmos5l_decap_4
x23[2] dvdd dvss sg13cmos5l_decap_4
x23[1] dvdd dvss sg13cmos5l_decap_4
x23[0] dvdd dvss sg13cmos5l_decap_4
x78[4] source_ena[4] dvdd dvss sg13cmos5l_antennanp
x78[3] source_ena[3] dvdd dvss sg13cmos5l_antennanp
x78[2] source_ena[2] dvdd dvss sg13cmos5l_antennanp
x78[1] source_ena[1] dvdd dvss sg13cmos5l_antennanp
x78[0] source_ena[0] dvdd dvss sg13cmos5l_antennanp
x9 shld_vdd pbias pcasc source_ena_b_3v3[0] source_ibias shld2 shld3 bias_pstack
x10[1] shld_vdd pbias pcasc source_ena_b_3v3[1] source_ibias shld2 shld3 bias_pstack
x10[0] shld_vdd pbias pcasc source_ena_b_3v3[1] source_ibias shld2 shld3 bias_pstack
x1[3] shld_vdd pbias pcasc source_ena_b_3v3[2] source_ibias shld2 shld3 bias_pstack
x1[2] shld_vdd pbias pcasc source_ena_b_3v3[2] source_ibias shld2 shld3 bias_pstack
x1[1] shld_vdd pbias pcasc source_ena_b_3v3[2] source_ibias shld2 shld3 bias_pstack
x1[0] shld_vdd pbias pcasc source_ena_b_3v3[2] source_ibias shld2 shld3 bias_pstack
x2[7] shld_vdd pbias pcasc source_ena_b_3v3[3] source_ibias shld2 shld3 bias_pstack
x2[6] shld_vdd pbias pcasc source_ena_b_3v3[3] source_ibias shld2 shld3 bias_pstack
x2[5] shld_vdd pbias pcasc source_ena_b_3v3[3] source_ibias shld2 shld3 bias_pstack
x2[4] shld_vdd pbias pcasc source_ena_b_3v3[3] source_ibias shld2 shld3 bias_pstack
x2[3] shld_vdd pbias pcasc source_ena_b_3v3[3] source_ibias shld2 shld3 bias_pstack
x2[2] shld_vdd pbias pcasc source_ena_b_3v3[3] source_ibias shld2 shld3 bias_pstack
x2[1] shld_vdd pbias pcasc source_ena_b_3v3[3] source_ibias shld2 shld3 bias_pstack
x2[0] shld_vdd pbias pcasc source_ena_b_3v3[3] source_ibias shld2 shld3 bias_pstack
x3[15] shld_vdd pbias pcasc source_ena_b_3v3[4] source_ibias shld2 shld3 bias_pstack
x3[14] shld_vdd pbias pcasc source_ena_b_3v3[4] source_ibias shld2 shld3 bias_pstack
x3[13] shld_vdd pbias pcasc source_ena_b_3v3[4] source_ibias shld2 shld3 bias_pstack
x3[12] shld_vdd pbias pcasc source_ena_b_3v3[4] source_ibias shld2 shld3 bias_pstack
x3[11] shld_vdd pbias pcasc source_ena_b_3v3[4] source_ibias shld2 shld3 bias_pstack
x3[10] shld_vdd pbias pcasc source_ena_b_3v3[4] source_ibias shld2 shld3 bias_pstack
x3[9] shld_vdd pbias pcasc source_ena_b_3v3[4] source_ibias shld2 shld3 bias_pstack
x3[8] shld_vdd pbias pcasc source_ena_b_3v3[4] source_ibias shld2 shld3 bias_pstack
x3[7] shld_vdd pbias pcasc source_ena_b_3v3[4] source_ibias shld2 shld3 bias_pstack
x3[6] shld_vdd pbias pcasc source_ena_b_3v3[4] source_ibias shld2 shld3 bias_pstack
x3[5] shld_vdd pbias pcasc source_ena_b_3v3[4] source_ibias shld2 shld3 bias_pstack
x3[4] shld_vdd pbias pcasc source_ena_b_3v3[4] source_ibias shld2 shld3 bias_pstack
x3[3] shld_vdd pbias pcasc source_ena_b_3v3[4] source_ibias shld2 shld3 bias_pstack
x3[2] shld_vdd pbias pcasc source_ena_b_3v3[4] source_ibias shld2 shld3 bias_pstack
x3[1] shld_vdd pbias pcasc source_ena_b_3v3[4] source_ibias shld2 shld3 bias_pstack
x3[0] shld_vdd pbias pcasc source_ena_b_3v3[4] source_ibias shld2 shld3 bias_pstack
.ends
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
