RTimothyEdwards/sg13cmos5l_ocd_ip__biasgen/netlist/layout/sg13cmos5l_ocd_ip__classab_buffer.spice

* NGSPICE file created from sg13cmos5l_ocd_ip__classab_buffer.ext - technology: ihp-sg13cmos5l

.subckt sg13_hv_pmos_QWE845 D0_0 S0_0 G0_0 D0_1 S0_1 G0_1 D1_0 S1_0 G1_0 D1_1 S1_1
+ G1_1 w_n1081_n1018#
X0 S0_0 G0_0 D0_0 w_n1081_n1018# sg13_hv_pmos ad=1.36p pd=8.68u as=1.36p ps=8.68u w=4u l=4u
X1 D1_0 G1_0 S1_0 w_n1081_n1018# sg13_hv_pmos ad=1.36p pd=8.68u as=1.36p ps=8.68u w=4u l=4u
X2 D1_1 G1_1 S1_1 w_n1081_n1018# sg13_hv_pmos ad=1.36p pd=8.68u as=1.36p ps=8.68u w=4u l=4u
X3 S0_1 G0_1 D0_1 w_n1081_n1018# sg13_hv_pmos ad=1.36p pd=8.68u as=1.36p ps=8.68u w=4u l=4u
.ends

.subckt sg13_hv_pmos_FJG4RK D S G w_n242_n155#
X0 S G D w_n242_n155# sg13_hv_pmos ad=0.17p pd=1.68u as=0.17p ps=1.68u w=0.5u l=0.5u
.ends

.subckt sg13_hv_pmos_MLH6U9 D S G w_n242_n224#
X0 S G D w_n242_n224# sg13_hv_pmos ad=0.34p pd=2.68u as=0.34p ps=2.68u w=1u l=0.5u
.ends

.subckt sg13_hv_nmos_BEHQUZ D0 S0 G0 D1 S1 G1 D2 S2 G2 D3 S3 G3 D4 S4 G4 D5 S5 G5
+ D6 S6 G6 D7 S7 G7 sub
X0 S4 G4 D4 sub sg13_hv_nmos ad=0.34p pd=2.68u as=0.34p ps=2.68u w=1u l=1u
X1 S6 G6 D6 sub sg13_hv_nmos ad=0.34p pd=2.68u as=0.34p ps=2.68u w=1u l=1u
X2 D5 G5 S5 sub sg13_hv_nmos ad=0.34p pd=2.68u as=0.34p ps=2.68u w=1u l=1u
X3 D7 G7 S7 sub sg13_hv_nmos ad=0.34p pd=2.68u as=0.34p ps=2.68u w=1u l=1u
X4 S0 G0 D0 sub sg13_hv_nmos ad=0.34p pd=2.68u as=0.34p ps=2.68u w=1u l=1u
X5 D1 G1 S1 sub sg13_hv_nmos ad=0.34p pd=2.68u as=0.34p ps=2.68u w=1u l=1u
X6 S2 G2 D2 sub sg13_hv_nmos ad=0.34p pd=2.68u as=0.34p ps=2.68u w=1u l=1u
X7 D3 G3 S3 sub sg13_hv_nmos ad=0.34p pd=2.68u as=0.34p ps=2.68u w=1u l=1u
.ends

.subckt sg13_hv_nmos_BEZCVZ D0 S0 G0 D1 S1 G1 D2 S2 G2 D3 S3 G3 sub
X0 S2 G2 D2 sub sg13_hv_nmos ad=0.34p pd=2.68u as=0.34p ps=2.68u w=1u l=1u
X1 D3 G3 S3 sub sg13_hv_nmos ad=0.34p pd=2.68u as=0.34p ps=2.68u w=1u l=1u
X2 S0 G0 D0 sub sg13_hv_nmos ad=0.34p pd=2.68u as=0.34p ps=2.68u w=1u l=1u
X3 D1 G1 S1 sub sg13_hv_nmos ad=0.34p pd=2.68u as=0.34p ps=2.68u w=1u l=1u
.ends

.subckt sg13_hv_pmos_ZK4LW2 D0 S0 G0 D1 S1 G1 D2 S2 G2 D3 S3 G3 D4 S4 G4 D5 S5 G5
+ D6 S6 G6 D7 S7 G7 D8 S8 G8 D9 S9 G9 D10 S10 G10 D11 S11 G11 w_n2371_n224#
X0 D5 G5 S5 w_n2371_n224# sg13_hv_pmos ad=0.34p pd=2.68u as=0.34p ps=2.68u w=1u l=1u
X1 S6 G6 D6 w_n2371_n224# sg13_hv_pmos ad=0.34p pd=2.68u as=0.34p ps=2.68u w=1u l=1u
X2 S0 G0 D0 w_n2371_n224# sg13_hv_pmos ad=0.34p pd=2.68u as=0.34p ps=2.68u w=1u l=1u
X3 D11 G11 S11 w_n2371_n224# sg13_hv_pmos ad=0.34p pd=2.68u as=0.34p ps=2.68u w=1u l=1u
X4 S8 G8 D8 w_n2371_n224# sg13_hv_pmos ad=0.34p pd=2.68u as=0.34p ps=2.68u w=1u l=1u
X5 S10 G10 D10 w_n2371_n224# sg13_hv_pmos ad=0.34p pd=2.68u as=0.34p ps=2.68u w=1u l=1u
X6 D7 G7 S7 w_n2371_n224# sg13_hv_pmos ad=0.34p pd=2.68u as=0.34p ps=2.68u w=1u l=1u
X7 D9 G9 S9 w_n2371_n224# sg13_hv_pmos ad=0.34p pd=2.68u as=0.34p ps=2.68u w=1u l=1u
X8 D1 G1 S1 w_n2371_n224# sg13_hv_pmos ad=0.34p pd=2.68u as=0.34p ps=2.68u w=1u l=1u
X9 S2 G2 D2 w_n2371_n224# sg13_hv_pmos ad=0.34p pd=2.68u as=0.34p ps=2.68u w=1u l=1u
X10 D3 G3 S3 w_n2371_n224# sg13_hv_pmos ad=0.34p pd=2.68u as=0.34p ps=2.68u w=1u l=1u
X11 S4 G4 D4 w_n2371_n224# sg13_hv_pmos ad=0.34p pd=2.68u as=0.34p ps=2.68u w=1u l=1u
.ends

.subckt sg13_hv_pmos_DFT6DG D0_0 S0_0 G0_0 D0_1 S0_1 G0_1 D0_2 S0_2 G0_2 D0_3 S0_3
+ G0_3 D1_0 S1_0 G1_0 D1_1 S1_1 G1_1 D1_2 S1_2 G1_2 D1_3 S1_3 G1_3 D2_0 S2_0 G2_0
+ D2_1 S2_1 G2_1 D2_2 S2_2 G2_2 D2_3 S2_3 G2_3 D3_0 S3_0 G3_0 D3_1 S3_1 G3_1 D3_2
+ S3_2 G3_2 D3_3 S3_3 G3_3 w_n2059_n806#
X0 S0_3 G0_3 D0_3 w_n2059_n806# sg13_hv_pmos ad=0.34p pd=2.68u as=0.34p ps=2.68u w=1u l=4u
X1 S0_0 G0_0 D0_0 w_n2059_n806# sg13_hv_pmos ad=0.34p pd=2.68u as=0.34p ps=2.68u w=1u l=4u
X2 D1_0 G1_0 S1_0 w_n2059_n806# sg13_hv_pmos ad=0.34p pd=2.68u as=0.34p ps=2.68u w=1u l=4u
X3 D3_2 G3_2 S3_2 w_n2059_n806# sg13_hv_pmos ad=0.34p pd=2.68u as=0.34p ps=2.68u w=1u l=4u
X4 S2_1 G2_1 D2_1 w_n2059_n806# sg13_hv_pmos ad=0.34p pd=2.68u as=0.34p ps=2.68u w=1u l=4u
X5 D3_1 G3_1 S3_1 w_n2059_n806# sg13_hv_pmos ad=0.34p pd=2.68u as=0.34p ps=2.68u w=1u l=4u
X6 S0_2 G0_2 D0_2 w_n2059_n806# sg13_hv_pmos ad=0.34p pd=2.68u as=0.34p ps=2.68u w=1u l=4u
X7 S2_2 G2_2 D2_2 w_n2059_n806# sg13_hv_pmos ad=0.34p pd=2.68u as=0.34p ps=2.68u w=1u l=4u
X8 S0_1 G0_1 D0_1 w_n2059_n806# sg13_hv_pmos ad=0.34p pd=2.68u as=0.34p ps=2.68u w=1u l=4u
X9 D3_3 G3_3 S3_3 w_n2059_n806# sg13_hv_pmos ad=0.34p pd=2.68u as=0.34p ps=2.68u w=1u l=4u
X10 D3_0 G3_0 S3_0 w_n2059_n806# sg13_hv_pmos ad=0.34p pd=2.68u as=0.34p ps=2.68u w=1u l=4u
X11 S2_0 G2_0 D2_0 w_n2059_n806# sg13_hv_pmos ad=0.34p pd=2.68u as=0.34p ps=2.68u w=1u l=4u
X12 S2_3 G2_3 D2_3 w_n2059_n806# sg13_hv_pmos ad=0.34p pd=2.68u as=0.34p ps=2.68u w=1u l=4u
X13 D1_2 G1_2 S1_2 w_n2059_n806# sg13_hv_pmos ad=0.34p pd=2.68u as=0.34p ps=2.68u w=1u l=4u
X14 D1_1 G1_1 S1_1 w_n2059_n806# sg13_hv_pmos ad=0.34p pd=2.68u as=0.34p ps=2.68u w=1u l=4u
X15 D1_3 G1_3 S1_3 w_n2059_n806# sg13_hv_pmos ad=0.34p pd=2.68u as=0.34p ps=2.68u w=1u l=4u
.ends

.subckt sg13_hv_nmos_T2KQE3 D0 S0 G0 D1 S1 G1 D2 S2 G2 D3 S3 G3 sub
X0 S0 G0 D0 sub sg13_hv_nmos ad=0.68p pd=4.68u as=0.68p ps=4.68u w=2u l=4u
X1 S2 G2 D2 sub sg13_hv_nmos ad=0.68p pd=4.68u as=0.68p ps=4.68u w=2u l=4u
X2 S3 G3 D3 sub sg13_hv_nmos ad=0.68p pd=4.68u as=0.68p ps=4.68u w=2u l=4u
X3 S1 G1 D1 sub sg13_hv_nmos ad=0.68p pd=4.68u as=0.68p ps=4.68u w=2u l=4u
.ends

.subckt sg13_hv_nmos_TAZSE3 D0_0 S0_0 G0_0 D0_1 S0_1 G0_1 D0_2 S0_2 G0_2 D0_3 S0_3
+ G0_3 D1_0 S1_0 G1_0 D1_1 S1_1 G1_1 D1_2 S1_2 G1_2 D1_3 S1_3 G1_3 D2_0 S2_0 G2_0
+ D2_1 S2_1 G2_1 D2_2 S2_2 G2_2 D2_3 S2_3 G2_3 D3_0 S3_0 G3_0 D3_1 S3_1 G3_1 D3_2
+ S3_2 G3_2 D3_3 S3_3 G3_3 sub
X0 S0_1 G0_1 D0_1 sub sg13_hv_nmos ad=0.68p pd=4.68u as=0.68p ps=4.68u w=2u l=4u
X1 S2_0 G2_0 D2_0 sub sg13_hv_nmos ad=0.68p pd=4.68u as=0.68p ps=4.68u w=2u l=4u
X2 D3_3 G3_3 S3_3 sub sg13_hv_nmos ad=0.68p pd=4.68u as=0.68p ps=4.68u w=2u l=4u
X3 S2_3 G2_3 D2_3 sub sg13_hv_nmos ad=0.68p pd=4.68u as=0.68p ps=4.68u w=2u l=4u
X4 D1_0 G1_0 S1_0 sub sg13_hv_nmos ad=0.68p pd=4.68u as=0.68p ps=4.68u w=2u l=4u
X5 D1_1 G1_1 S1_1 sub sg13_hv_nmos ad=0.68p pd=4.68u as=0.68p ps=4.68u w=2u l=4u
X6 D1_3 G1_3 S1_3 sub sg13_hv_nmos ad=0.68p pd=4.68u as=0.68p ps=4.68u w=2u l=4u
X7 D3_2 G3_2 S3_2 sub sg13_hv_nmos ad=0.68p pd=4.68u as=0.68p ps=4.68u w=2u l=4u
X8 S0_3 G0_3 D0_3 sub sg13_hv_nmos ad=0.68p pd=4.68u as=0.68p ps=4.68u w=2u l=4u
X9 S0_2 G0_2 D0_2 sub sg13_hv_nmos ad=0.68p pd=4.68u as=0.68p ps=4.68u w=2u l=4u
X10 S0_0 G0_0 D0_0 sub sg13_hv_nmos ad=0.68p pd=4.68u as=0.68p ps=4.68u w=2u l=4u
X11 S2_2 G2_2 D2_2 sub sg13_hv_nmos ad=0.68p pd=4.68u as=0.68p ps=4.68u w=2u l=4u
X12 D3_0 G3_0 S3_0 sub sg13_hv_nmos ad=0.68p pd=4.68u as=0.68p ps=4.68u w=2u l=4u
X13 S2_1 G2_1 D2_1 sub sg13_hv_nmos ad=0.68p pd=4.68u as=0.68p ps=4.68u w=2u l=4u
X14 D3_1 G3_1 S3_1 sub sg13_hv_nmos ad=0.68p pd=4.68u as=0.68p ps=4.68u w=2u l=4u
X15 D1_2 G1_2 S1_2 sub sg13_hv_nmos ad=0.68p pd=4.68u as=0.68p ps=4.68u w=2u l=4u
.ends

.subckt sg13_hv_pmos_NQD9LU D0_0 S0_0 G0_0 D0_1 S0_1 G0_1 D1_0 S1_0 G1_0 D1_1 S1_1
+ G1_1 D2_0 S2_0 G2_0 D2_1 S2_1 G2_1 D3_0 S3_0 G3_0 D3_1 S3_1 G3_1 D4_0 S4_0 G4_0
+ D4_1 S4_1 G4_1 D5_0 S5_0 G5_0 D5_1 S5_1 G5_1 D6_0 S6_0 G6_0 D6_1 S6_1 G6_1 D7_0
+ S7_0 G7_0 D7_1 S7_1 G7_1 w_n1615_n418#
X0 S6_0 G6_0 D6_0 w_n1615_n418# sg13_hv_pmos ad=0.34p pd=2.68u as=0.34p ps=2.68u w=1u l=1u
X1 D5_1 G5_1 S5_1 w_n1615_n418# sg13_hv_pmos ad=0.34p pd=2.68u as=0.34p ps=2.68u w=1u l=1u
X2 S2_1 G2_1 D2_1 w_n1615_n418# sg13_hv_pmos ad=0.34p pd=2.68u as=0.34p ps=2.68u w=1u l=1u
X3 D7_0 G7_0 S7_0 w_n1615_n418# sg13_hv_pmos ad=0.34p pd=2.68u as=0.34p ps=2.68u w=1u l=1u
X4 D1_1 G1_1 S1_1 w_n1615_n418# sg13_hv_pmos ad=0.34p pd=2.68u as=0.34p ps=2.68u w=1u l=1u
X5 D7_1 G7_1 S7_1 w_n1615_n418# sg13_hv_pmos ad=0.34p pd=2.68u as=0.34p ps=2.68u w=1u l=1u
X6 D3_1 G3_1 S3_1 w_n1615_n418# sg13_hv_pmos ad=0.34p pd=2.68u as=0.34p ps=2.68u w=1u l=1u
X7 D3_0 G3_0 S3_0 w_n1615_n418# sg13_hv_pmos ad=0.34p pd=2.68u as=0.34p ps=2.68u w=1u l=1u
X8 S4_0 G4_0 D4_0 w_n1615_n418# sg13_hv_pmos ad=0.34p pd=2.68u as=0.34p ps=2.68u w=1u l=1u
X9 S2_0 G2_0 D2_0 w_n1615_n418# sg13_hv_pmos ad=0.34p pd=2.68u as=0.34p ps=2.68u w=1u l=1u
X10 S4_1 G4_1 D4_1 w_n1615_n418# sg13_hv_pmos ad=0.34p pd=2.68u as=0.34p ps=2.68u w=1u l=1u
X11 S6_1 G6_1 D6_1 w_n1615_n418# sg13_hv_pmos ad=0.34p pd=2.68u as=0.34p ps=2.68u w=1u l=1u
X12 D1_0 G1_0 S1_0 w_n1615_n418# sg13_hv_pmos ad=0.34p pd=2.68u as=0.34p ps=2.68u w=1u l=1u
X13 D5_0 G5_0 S5_0 w_n1615_n418# sg13_hv_pmos ad=0.34p pd=2.68u as=0.34p ps=2.68u w=1u l=1u
X14 S0_1 G0_1 D0_1 w_n1615_n418# sg13_hv_pmos ad=0.34p pd=2.68u as=0.34p ps=2.68u w=1u l=1u
X15 S0_0 G0_0 D0_0 w_n1615_n418# sg13_hv_pmos ad=0.34p pd=2.68u as=0.34p ps=2.68u w=1u l=1u
.ends

.subckt sg13_hv_pmos_V3Q6DG D0 S0 G0 D1 S1 G1 D2 S2 G2 D3 S3 G3 w_n592_n806#
X0 S0 G0 D0 w_n592_n806# sg13_hv_pmos ad=0.34p pd=2.68u as=0.34p ps=2.68u w=1u l=4u
X1 S2 G2 D2 w_n592_n806# sg13_hv_pmos ad=0.34p pd=2.68u as=0.34p ps=2.68u w=1u l=4u
X2 S3 G3 D3 w_n592_n806# sg13_hv_pmos ad=0.34p pd=2.68u as=0.34p ps=2.68u w=1u l=4u
X3 S1 G1 D1 w_n592_n806# sg13_hv_pmos ad=0.34p pd=2.68u as=0.34p ps=2.68u w=1u l=4u
.ends

.subckt sg13_hv_pmos_NED9LU D0_0 S0_0 G0_0 D0_1 S0_1 G0_1 D1_0 S1_0 G1_0 D1_1 S1_1
+ G1_1 D2_0 S2_0 G2_0 D2_1 S2_1 G2_1 D3_0 S3_0 G3_0 D3_1 S3_1 G3_1 w_n859_n1018#
X0 D3_0 G3_0 S3_0 w_n859_n1018# sg13_hv_pmos ad=1.36p pd=8.68u as=1.36p ps=8.68u w=4u l=1u
X1 D3_1 G3_1 S3_1 w_n859_n1018# sg13_hv_pmos ad=1.36p pd=8.68u as=1.36p ps=8.68u w=4u l=1u
X2 S0_1 G0_1 D0_1 w_n859_n1018# sg13_hv_pmos ad=1.36p pd=8.68u as=1.36p ps=8.68u w=4u l=1u
X3 D1_1 G1_1 S1_1 w_n859_n1018# sg13_hv_pmos ad=1.36p pd=8.68u as=1.36p ps=8.68u w=4u l=1u
X4 D1_0 G1_0 S1_0 w_n859_n1018# sg13_hv_pmos ad=1.36p pd=8.68u as=1.36p ps=8.68u w=4u l=1u
X5 S2_0 G2_0 D2_0 w_n859_n1018# sg13_hv_pmos ad=1.36p pd=8.68u as=1.36p ps=8.68u w=4u l=1u
X6 S2_1 G2_1 D2_1 w_n859_n1018# sg13_hv_pmos ad=1.36p pd=8.68u as=1.36p ps=8.68u w=4u l=1u
X7 S0_0 G0_0 D0_0 w_n859_n1018# sg13_hv_pmos ad=1.36p pd=8.68u as=1.36p ps=8.68u w=4u l=1u
.ends

.subckt sg13_hv_pmos_NQUDLU D0 S0 G0 D1 S1 G1 D2 S2 G2 D3 S3 G3 w_n859_n224#
X0 D1 G1 S1 w_n859_n224# sg13_hv_pmos ad=0.34p pd=2.68u as=0.34p ps=2.68u w=1u l=1u
X1 S2 G2 D2 w_n859_n224# sg13_hv_pmos ad=0.34p pd=2.68u as=0.34p ps=2.68u w=1u l=1u
X2 D3 G3 S3 w_n859_n224# sg13_hv_pmos ad=0.34p pd=2.68u as=0.34p ps=2.68u w=1u l=1u
X3 S0 G0 D0 w_n859_n224# sg13_hv_pmos ad=0.34p pd=2.68u as=0.34p ps=2.68u w=1u l=1u
.ends

.subckt sg13_hv_nmos_BENXUZ D0_0 S0_0 G0_0 D0_1 S0_1 G0_1 D1_0 S1_0 G1_0 D1_1 S1_1
+ G1_1 D2_0 S2_0 G2_0 D2_1 S2_1 G2_1 D3_0 S3_0 G3_0 D3_1 S3_1 G3_1 sub
X0 D3_1 G3_1 S3_1 sub sg13_hv_nmos ad=0.68p pd=4.68u as=0.68p ps=4.68u w=2u l=1u
X1 S0_1 G0_1 D0_1 sub sg13_hv_nmos ad=0.68p pd=4.68u as=0.68p ps=4.68u w=2u l=1u
X2 D3_0 G3_0 S3_0 sub sg13_hv_nmos ad=0.68p pd=4.68u as=0.68p ps=4.68u w=2u l=1u
X3 D1_1 G1_1 S1_1 sub sg13_hv_nmos ad=0.68p pd=4.68u as=0.68p ps=4.68u w=2u l=1u
X4 S2_1 G2_1 D2_1 sub sg13_hv_nmos ad=0.68p pd=4.68u as=0.68p ps=4.68u w=2u l=1u
X5 S2_0 G2_0 D2_0 sub sg13_hv_nmos ad=0.68p pd=4.68u as=0.68p ps=4.68u w=2u l=1u
X6 D1_0 G1_0 S1_0 sub sg13_hv_nmos ad=0.68p pd=4.68u as=0.68p ps=4.68u w=2u l=1u
X7 S0_0 G0_0 D0_0 sub sg13_hv_nmos ad=0.68p pd=4.68u as=0.68p ps=4.68u w=2u l=1u
.ends

.subckt capacitor_W9X9FK sub c1 c2
X0 c1 c2 cap_cmomf mm_ok=1 subblock=1 mmax=4 mmin=1 l=15.5u w=35.317u
.ends

.subckt sg13_hv_nmos_QMKJVU D S G sub
X0 S G D sub sg13_hv_nmos ad=1.36p pd=8.68u as=1.36p ps=8.68u w=4u l=0.45u
.ends

.subckt sg13_hv_nmos_XAS6UC D0_0 S0_0 G0_0 D0_1 S0_1 G0_1 D1_0 S1_0 G1_0 D1_1 S1_1
+ G1_1 D2_0 S2_0 G2_0 D2_1 S2_1 G2_1 D3_0 S3_0 G3_0 D3_1 S3_1 G3_1 D4_0 S4_0 G4_0
+ D4_1 S4_1 G4_1 D5_0 S5_0 G5_0 D5_1 S5_1 G5_1 D6_0 S6_0 G6_0 D6_1 S6_1 G6_1 D7_0
+ S7_0 G7_0 D7_1 S7_1 G7_1 D8_0 S8_0 G8_0 D8_1 S8_1 G8_1 D9_0 S9_0 G9_0 D9_1 S9_1
+ G9_1 D10_0 S10_0 G10_0 D10_1 S10_1 G10_1 D11_0 S11_0 G11_0 D11_1 S11_1 G11_1 sub
X0 S0_1 G0_1 D0_1 sub sg13_hv_nmos ad=0.34p pd=2.68u as=0.34p ps=2.68u w=1u l=1u
X1 D7_1 G7_1 S7_1 sub sg13_hv_nmos ad=0.34p pd=2.68u as=0.34p ps=2.68u w=1u l=1u
X2 S4_1 G4_1 D4_1 sub sg13_hv_nmos ad=0.34p pd=2.68u as=0.34p ps=2.68u w=1u l=1u
X3 D9_0 G9_0 S9_0 sub sg13_hv_nmos ad=0.34p pd=2.68u as=0.34p ps=2.68u w=1u l=1u
X4 D3_1 G3_1 S3_1 sub sg13_hv_nmos ad=0.34p pd=2.68u as=0.34p ps=2.68u w=1u l=1u
X5 D11_1 G11_1 S11_1 sub sg13_hv_nmos ad=0.34p pd=2.68u as=0.34p ps=2.68u w=1u l=1u
X6 S10_0 G10_0 D10_0 sub sg13_hv_nmos ad=0.34p pd=2.68u as=0.34p ps=2.68u w=1u l=1u
X7 D9_1 G9_1 S9_1 sub sg13_hv_nmos ad=0.34p pd=2.68u as=0.34p ps=2.68u w=1u l=1u
X8 S6_0 G6_0 D6_0 sub sg13_hv_nmos ad=0.34p pd=2.68u as=0.34p ps=2.68u w=1u l=1u
X9 D11_0 G11_0 S11_0 sub sg13_hv_nmos ad=0.34p pd=2.68u as=0.34p ps=2.68u w=1u l=1u
X10 D5_1 G5_1 S5_1 sub sg13_hv_nmos ad=0.34p pd=2.68u as=0.34p ps=2.68u w=1u l=1u
X11 D5_0 G5_0 S5_0 sub sg13_hv_nmos ad=0.34p pd=2.68u as=0.34p ps=2.68u w=1u l=1u
X12 S0_0 G0_0 D0_0 sub sg13_hv_nmos ad=0.34p pd=2.68u as=0.34p ps=2.68u w=1u l=1u
X13 S4_0 G4_0 D4_0 sub sg13_hv_nmos ad=0.34p pd=2.68u as=0.34p ps=2.68u w=1u l=1u
X14 D1_1 G1_1 S1_1 sub sg13_hv_nmos ad=0.34p pd=2.68u as=0.34p ps=2.68u w=1u l=1u
X15 S6_1 G6_1 D6_1 sub sg13_hv_nmos ad=0.34p pd=2.68u as=0.34p ps=2.68u w=1u l=1u
X16 S8_1 G8_1 D8_1 sub sg13_hv_nmos ad=0.34p pd=2.68u as=0.34p ps=2.68u w=1u l=1u
X17 D3_0 G3_0 S3_0 sub sg13_hv_nmos ad=0.34p pd=2.68u as=0.34p ps=2.68u w=1u l=1u
X18 D7_0 G7_0 S7_0 sub sg13_hv_nmos ad=0.34p pd=2.68u as=0.34p ps=2.68u w=1u l=1u
X19 S2_0 G2_0 D2_0 sub sg13_hv_nmos ad=0.34p pd=2.68u as=0.34p ps=2.68u w=1u l=1u
X20 S2_1 G2_1 D2_1 sub sg13_hv_nmos ad=0.34p pd=2.68u as=0.34p ps=2.68u w=1u l=1u
X21 S10_1 G10_1 D10_1 sub sg13_hv_nmos ad=0.34p pd=2.68u as=0.34p ps=2.68u w=1u l=1u
X22 D1_0 G1_0 S1_0 sub sg13_hv_nmos ad=0.34p pd=2.68u as=0.34p ps=2.68u w=1u l=1u
X23 S8_0 G8_0 D8_0 sub sg13_hv_nmos ad=0.34p pd=2.68u as=0.34p ps=2.68u w=1u l=1u
.ends

.subckt sg13_hv_nmos_2G82VR D0_0 S0_0 G0_0 D0_1 S0_1 G0_1 D1_0 S1_0 G1_0 D1_1 S1_1
+ G1_1 sub
X0 S0_0 G0_0 D0_0 sub sg13_hv_nmos ad=1.36p pd=8.68u as=1.36p ps=8.68u w=4u l=4u
X1 D1_0 G1_0 S1_0 sub sg13_hv_nmos ad=1.36p pd=8.68u as=1.36p ps=8.68u w=4u l=4u
X2 D1_1 G1_1 S1_1 sub sg13_hv_nmos ad=1.36p pd=8.68u as=1.36p ps=8.68u w=4u l=4u
X3 S0_1 G0_1 D0_1 sub sg13_hv_nmos ad=1.36p pd=8.68u as=1.36p ps=8.68u w=4u l=4u
.ends

.subckt se_folded_cascode_np_ab vdd out inp vss bias ena inn
XXMOP out vdd XM9/S3_2 out vdd XM9/S3_2 vdd out XM9/S3_2 vdd out XM9/S3_2 vdd sg13_hv_pmos_QWE845
Xsg13_hv_pmos_FJG4RK_0 vdd bias ena vdd sg13_hv_pmos_FJG4RK
Xsg13_hv_pmos_MLH6U9_0 XM9/S3_2 vdd ena vdd sg13_hv_pmos_MLH6U9
Xsg13_hv_nmos_BEHQUZ_0 vss vss vss vss vss vss vss vss vss vss vss vss vss vss vss
+ vss vss vss vss vss vss vss vss vss vss sg13_hv_nmos_BEHQUZ
Xsg13_hv_nmos_BEZCVZ_0 vss vss vss vss vss vss vss vss vss vss vss vss vss sg13_hv_nmos_BEZCVZ
XXM4 vdd outa1n outa1n outa1p vdd outa1n vdd outa1n outa1n outa1p vdd outa1n vdd outa1n
+ outa1n outa1p vdd outa1n vdd outa1n outa1n outa1p vdd outa1n vdd outa1n outa1n outa1p
+ vdd outa1n vdd outa1n outa1n outa1p vdd outa1n vdd sg13_hv_pmos_ZK4LW2
XXM5 vdd outa1n outa1n outa1p vdd outa1n vdd outa1n outa1n outa1p vdd outa1n vdd outa1n
+ outa1n outa1p vdd outa1n vdd outa1n outa1n outa1p vdd outa1n vdd outa1n outa1n outa1p
+ vdd outa1n vdd outa1n outa1n outa1p vdd outa1n vdd sg13_hv_pmos_ZK4LW2
XXM6 XM9/S3_2 outa1p XM9/S3_3 outa1n XM9/S3_3 XM9/S3_3 XM9/S3_2 outa1p XM9/S3_3 outa1n
+ XM9/S3_3 XM9/S3_3 XM9/S3_3 outa1n XM9/S3_3 outa1p XM9/S3_2 XM9/S3_3 XM9/S3_3 outa1n
+ XM9/S3_3 outa1p XM9/S3_2 XM9/S3_3 XM9/S3_2 outa1p XM9/S3_3 outa1n XM9/S3_3 XM9/S3_3
+ XM9/S3_2 outa1p XM9/S3_3 outa1n XM9/S3_3 XM9/S3_3 XM9/S3_3 outa1n XM9/S3_3 outa1p
+ XM9/S3_2 XM9/S3_3 XM9/S3_3 outa1n XM9/S3_3 outa1p XM9/S3_2 XM9/S3_3 vdd sg13_hv_pmos_DFT6DG
XXM7 XM9/S3_2 outa1p XM9/S3_3 outa1n XM9/S3_3 XM9/S3_3 XM9/S3_2 outa1p XM9/S3_3 outa1n
+ XM9/S3_3 XM9/S3_3 XM9/S3_3 outa1n XM9/S3_3 outa1p XM9/S3_2 XM9/S3_3 XM9/S3_3 outa1n
+ XM9/S3_3 outa1p XM9/S3_2 XM9/S3_3 XM9/S3_2 outa1p XM9/S3_3 outa1n XM9/S3_3 XM9/S3_3
+ XM9/S3_2 outa1p XM9/S3_3 outa1n XM9/S3_3 XM9/S3_3 XM9/S3_3 outa1n XM9/S3_3 outa1p
+ XM9/S3_2 XM9/S3_3 XM9/S3_3 outa1n XM9/S3_3 outa1p XM9/S3_2 XM9/S3_3 vdd sg13_hv_pmos_DFT6DG
XXMB1 vbn1 vbn2 vbn2 vbn1 vbn2 vbn2 vbn1 vbn2 vbn2 vbn1 vbn2 vbn2 vss sg13_hv_nmos_T2KQE3
XXM8 XM9/S3_3 outb1n vbn2 XM9/S3_2 outb1p vbn2 XM9/S3_3 outb1n vbn2 XM9/S3_2 outb1p
+ vbn2 outb1p XM9/S3_2 vbn2 outb1n XM9/S3_3 vbn2 outb1p XM9/S3_2 vbn2 outb1n XM9/S3_3
+ vbn2 XM9/S3_3 outb1n vbn2 XM9/S3_2 outb1p vbn2 XM9/S3_3 outb1n vbn2 XM9/S3_2 outb1p
+ vbn2 outb1p XM9/S3_2 vbn2 outb1n XM9/S3_3 vbn2 outb1p XM9/S3_2 vbn2 outb1n XM9/S3_3
+ vbn2 vss sg13_hv_nmos_TAZSE3
XXMB2 vss vbn1 vbn1 vbn1 vss vbn1 vss vbn1 vbn1 vbn1 vss vbn1 vss sg13_hv_nmos_BEZCVZ
XXMIP1 vdd diffb vbp1 vdd diffb vbp1 diffb vdd vbp1 diffb vdd vbp1 vdd diffb vbp1
+ vdd diffb vbp1 diffb vdd vbp1 diffb vdd vbp1 vdd diffb vbp1 vdd diffb vbp1 diffb
+ vdd vbp1 diffb vdd vbp1 vdd diffb vbp1 vdd diffb vbp1 diffb vdd vbp1 diffb vdd vbp1
+ vdd sg13_hv_pmos_NQD9LU
XXM9 XM9/S3_3 outb1n vbn2 XM9/S3_2 outb1p vbn2 XM9/S3_3 outb1n vbn2 XM9/S3_2 outb1p
+ vbn2 outb1p XM9/S3_2 vbn2 outb1n XM9/S3_3 vbn2 outb1p XM9/S3_2 vbn2 outb1n XM9/S3_3
+ vbn2 XM9/S3_3 outb1n vbn2 XM9/S3_2 outb1p vbn2 XM9/S3_3 outb1n vbn2 XM9/S3_2 outb1p
+ vbn2 outb1p XM9/S3_2 vbn2 outb1n XM9/S3_3 vbn2 outb1p XM9/S3_2 vbn2 outb1n XM9/S3_3
+ vbn2 vss sg13_hv_nmos_TAZSE3
XXMB3 vdd vdd vdd vdd vdd vdd vdd vdd vdd vdd vdd vdd vdd sg13_hv_pmos_V3Q6DG
XXMIP2 outb1n diffb inn outb1p diffb inp diffb outb1p inp diffb outb1n inn outb1n
+ diffb inn outb1p diffb inp diffb outb1p inp diffb outb1n inn vdd sg13_hv_pmos_NED9LU
XXMB4 vbp1 bias bias vbp1 bias bias vbp1 bias bias vbp1 bias bias vdd sg13_hv_pmos_V3Q6DG
XXMIP3 outb1n diffb inn outb1p diffb inp diffb outb1p inp diffb outb1n inn outb1n
+ diffb inn outb1p diffb inp diffb outb1p inp diffb outb1n inn vdd sg13_hv_pmos_NED9LU
XXMIN1 vss diffa vbn1 diffa vss vbn1 vss diffa vbn1 diffa vss vbn1 vss diffa vbn1
+ diffa vss vbn1 vss diffa vbn1 diffa vss vbn1 vss sg13_hv_nmos_BEHQUZ
XXMB5 vdd vbn2 vbp1 vbp1 vdd vbp1 vdd vbn2 vbp1 vbp1 vdd vbp1 vdd sg13_hv_pmos_NQUDLU
XXMIN2 outa1n diffa inn outa1p diffa inp diffa outa1p inp diffa outa1n inn outa1n
+ diffa inn outa1p diffa inp diffa outa1p inp diffa outa1n inn vss sg13_hv_nmos_BENXUZ
XXMB6 vdd vbn2 vbp1 vbp1 vdd vbp1 vdd vbn2 vbp1 vbp1 vdd vbp1 vdd sg13_hv_pmos_NQUDLU
XXMIN3 outa1n diffa inn outa1p diffa inp diffa outa1p inp diffa outa1n inn outa1n
+ diffa inn outa1p diffa inp diffa outa1p inp diffa outa1n inn vss sg13_hv_nmos_BENXUZ
XC1[1] vss XM9/S3_2 out capacitor_W9X9FK
XC1[0] vss XM9/S3_2 out capacitor_W9X9FK
Xsg13_hv_nmos_QMKJVU_0 vss XMON/S0_1 ena vss sg13_hv_nmos_QMKJVU
Xsg13_hv_nmos_QMKJVU_1 vss XMON/S0_1 ena vss sg13_hv_nmos_QMKJVU
Xsg13_hv_nmos_QMKJVU_2 vss XMON/S0_1 ena vss sg13_hv_nmos_QMKJVU
XXM10 vss outb1p vbn1 vss outb1p vbn1 outb1n vss vbn1 outb1n vss vbn1 vss outb1p vbn1
+ vss outb1p vbn1 outb1n vss vbn1 outb1n vss vbn1 vss outb1p vbn1 vss outb1p vbn1
+ outb1n vss vbn1 outb1n vss vbn1 vss outb1p vbn1 vss outb1p vbn1 outb1n vss vbn1
+ outb1n vss vbn1 vss outb1p vbn1 vss outb1p vbn1 outb1n vss vbn1 outb1n vss vbn1
+ vss outb1p vbn1 vss outb1p vbn1 outb1n vss vbn1 outb1n vss vbn1 vss sg13_hv_nmos_XAS6UC
XXMON out XMON/S0_1 XM9/S3_2 out XMON/S0_1 XM9/S3_2 XMON/S0_1 out XM9/S3_2 XMON/S0_1
+ out XM9/S3_2 vss sg13_hv_nmos_2G82VR
Xsg13_hv_nmos_T2KQE3_0 vss vss vbn2 vss vss vbn2 vss vss vbn2 vss vss vbn2 vss sg13_hv_nmos_T2KQE3
Xsg13_hv_nmos_QMKJVU_3 vss XMON/S0_1 ena vss sg13_hv_nmos_QMKJVU
XXM11 vss outb1p vbn1 vss outb1p vbn1 outb1n vss vbn1 outb1n vss vbn1 vss outb1p vbn1
+ vss outb1p vbn1 outb1n vss vbn1 outb1n vss vbn1 vss outb1p vbn1 vss outb1p vbn1
+ outb1n vss vbn1 outb1n vss vbn1 vss outb1p vbn1 vss outb1p vbn1 outb1n vss vbn1
+ outb1n vss vbn1 vss outb1p vbn1 vss outb1p vbn1 outb1n vss vbn1 outb1n vss vbn1
+ vss outb1p vbn1 vss outb1p vbn1 outb1n vss vbn1 outb1n vss vbn1 vss sg13_hv_nmos_XAS6UC
.ends

.subckt sg13cmos5l_ocd_ip__classab_buffer vdd vss inp ena bias out
Xse_folded_cascode_np_ab_0 vdd out inp vss bias ena out se_folded_cascode_np_ab
.ends
