RTimothyEdwards/sg13cmos5l_ocd_ip__biasgen/netlist/rcx/sg13cmos5l_ocd_ip__bandgap_v3.spice

* NGSPICE file created from sg13cmos5l_ocd_ip__bandgap_v3.ext - technology: ihp-sg13cmos5l

.subckt sg13cmos5l_ocd_ip__bandgap_v3 vdd vbg vss ibias1_250n trim[15] trim[14] trim[13]
+ trim[12] trim[11] trim[10] trim[9] trim[8] trim[7] trim[6] trim[5] trim[4] trim[3]
+ trim[2] trim[1] trim[0] dvss dvdd ena ibias2_1u
X0 x2.outb1n.t25 x2.vbn1 vss.t120 vss.t407 sg13_hv_nmos ad=0.34p pd=2.68u as=0.34p ps=2.68u w=1u l=1u
X1 x2.diffb x2.vbp1 vdd.t252 vdd.t5 sg13_hv_pmos ad=0.34p pd=2.68u as=0.34p ps=2.68u w=1u l=1u
X2 x1.xamp.vbn1 x1.xamp.vbn1 vss.t59 vss.t60 sg13_hv_nmos ad=0.34p pd=2.68u as=0.34p ps=2.68u w=1u l=1u
X3 x2.diffb vbg.t17 x2.outb1n.t22 vdd.t5 sg13_hv_pmos ad=1.36p pd=8.68u as=1.36p ps=8.68u w=4u l=1u
X4 x1.xtr.XM0[1].S x1.XQ2_7.E vss.t0 rppd l=3.4u w=1.41u
X5 vss.t59 vss.t59 vss.t234 rhigh l=20u w=0.69u
X6 vss.t271 x1.level_shift_0[5].in_n x1.level_shift_0[5].XM7.G0 vss.t172 sg13_hv_nmos ad=0.76p pd=4.38u as=1.36p ps=8.68u w=4u l=0.5u
X7 x2.XM9.D0_0 x2.XM9.D0_0 x2.outa1n.t33 vdd.t5 sg13_hv_pmos ad=0.34p pd=2.68u as=0.34p ps=2.68u w=1u l=4u
X8 x1.XM1.G0 x1.xamp.vbp2 x1.xamp.XM8.D0 vdd.t6 sg13_hv_pmos ad=0.68p pd=4.68u as=0.68p ps=4.68u w=2u l=4u
X9 vss.t59 vss.t59 vss.t59 vss.t75 sg13_hv_nmos ad=0.34p pd=2.68u as=0 ps=0 w=1u l=1u
X10 x2.diffb x1.vbg x2.outb1p.t6 vdd.t5 sg13_hv_pmos ad=1.36p pd=8.68u as=1.36p ps=8.68u w=4u l=1u
X11 x2.diffa vbg.t10 x2.outa1n.t45 vss.t99 sg13_hv_nmos ad=0.68p pd=4.68u as=0.68p ps=4.68u w=2u l=1u
X12 x1.xtr.XM0[3].S x1.xtr.XM0[2].S vss.t0 rppd l=3.4u w=1.41u
X13 x1.xamp.vbn1 x1.xamp.vbn1 vss.t59 vss.t60 sg13_hv_nmos ad=0.34p pd=2.68u as=0.34p ps=2.68u w=1u l=1u
X14 x1.xamp.XM1.S0 x1.xamp.vbp1 vdd.t6 vdd.t6 sg13_hv_pmos ad=0.34p pd=2.68u as=0.34p ps=2.68u w=1u l=1u
X15 vss.t177 x1.x1[2].in_n x1.x1[2].XM7.G0 vss.t236 sg13_hv_nmos ad=0.76p pd=4.38u as=1.36p ps=8.68u w=4u l=0.5u
X16 x1.xamp.XM1.S0 x1.xamp.vbp1 vdd.t6 vdd.t6 sg13_hv_pmos ad=0.34p pd=2.68u as=0.34p ps=2.68u w=1u l=1u
X17 x1.xtr.XM0[4].S x1.xtr.XM0[3].S vss.t0 rppd l=3.4u w=1.41u
X18 vdd.t146 x1.level_shift_0[0].XM7.D0 x1.level_shift_0[0].out vdd.t0 sg13_hv_pmos ad=0.68p pd=4.68u as=0.38p ps=2.38u w=2u l=0.5u
X19 vdd.t31 x1.xamp.XM6.S0 x1.xamp.XM8.D0 vdd.t6 sg13_hv_pmos ad=0.68p pd=4.68u as=0.68p ps=4.68u w=2u l=4u
X20 vss.t380 x1.x1[0].in_p x1.x1[0].XM2.D0 vss.t381 sg13_hv_nmos ad=0.76p pd=4.38u as=1.36p ps=8.68u w=4u l=0.5u
X21 x1.x1[2].out x1.x1[2].XM7.D0 vss.t177 vss.t176 sg13_hv_nmos ad=0.19p pd=1.38u as=0.34p ps=2.68u w=1u l=0.5u
X22 x2.vbn2 x2.vbn2 x2.vbn1 vss.t306 sg13_hv_nmos ad=0.68p pd=4.68u as=0.68p ps=4.68u w=2u l=4u
X23 vdd.t57 x1.x1[0].XM7.D0 x1.ena_b_h vdd.t0 sg13_hv_pmos ad=0.68p pd=4.68u as=0.38p ps=2.38u w=2u l=0.5u
X24 x1.level_shift_0[0].XM7.G0 x1.level_shift_0[0].XM2.D0 vdd.t198 vdd.t0 sg13_hv_pmos ad=0.34p pd=2.68u as=0.19p ps=1.38u w=1u l=0.5u
X25 vdd.t111 x1.level_shift_0[6].XM7.G0 x1.level_shift_0[6].XM7.D0 vdd.t0 sg13_hv_pmos ad=0.38p pd=2.38u as=0.68p ps=4.68u w=2u l=0.5u
X26 x1.xtr.XM0[7].S x1.xtr.XM0[6].S vss.t0 rppd l=3.4u w=1.41u
X27 x1.xamp.out1n x1.xres.d x1.xamp.XM1.S0 vdd.t6 sg13_hv_pmos ad=1.36p pd=8.68u as=1.36p ps=8.68u w=4u l=1u
X28 x2.outb1p.t30 x2.vbn1 vss.t95 vss.t414 sg13_hv_nmos ad=0.34p pd=2.68u as=0.34p ps=2.68u w=1u l=1u
X29 x2.diffa x1.vbg x2.outa1p.t2 vss.t24 sg13_hv_nmos ad=0.68p pd=4.68u as=0.68p ps=4.68u w=2u l=1u
X30 x1.x1[5].out x1.x1[5].XM7.D0 vdd.t159 vdd.t0 sg13_hv_pmos ad=0.38p pd=2.38u as=0.38p ps=2.38u w=2u l=0.5u
X31 x2.outb1n.t30 x2.vbn1 vss.t95 vss.t415 sg13_hv_nmos ad=0.34p pd=2.68u as=0.34p ps=2.68u w=1u l=1u
X32 x2.XMB4.S0 x1.ena_b_h ibias2_1u vdd.t5 sg13_hv_pmos ad=0.34p pd=2.68u as=0.34p ps=2.68u w=1u l=4u
X33 vdd.t93 x1.level_shift_0[3].XM7.D0 x1.level_shift_0[3].out vdd.t0 sg13_hv_pmos ad=0.68p pd=4.68u as=0.38p ps=2.38u w=2u l=0.5u
X34 x2.diffa vbg.t13 x2.outa1n.t42 vss.t350 sg13_hv_nmos ad=0.68p pd=4.68u as=0.68p ps=4.68u w=2u l=1u
X35 x2.outa1p.t34 x2.outa1n.t50 vdd.t5 vdd.t5 sg13_hv_pmos ad=0.34p pd=2.68u as=0.34p ps=2.68u w=1u l=1u
X36 vdd.t288 x1.x1[7].XM7.D0 x1.x1[7].out vdd.t0 sg13_hv_pmos ad=0.68p pd=4.68u as=0.38p ps=2.38u w=2u l=0.5u
X37 vdd.t157 x1.x1[7].XM7.G0 x1.x1[7].XM2.D0 vdd.t0 sg13_hv_pmos ad=0.19p pd=1.38u as=0.34p ps=2.68u w=1u l=0.5u
X38 x1.XM1.G0 x1.xamp.vbn2 x1.xamp.out1p vss.t181 sg13_hv_nmos ad=0.34p pd=2.68u as=0.34p ps=2.68u w=1u l=4u
X39 x1.xamp.out1p x1.xamp.vbn1 vss.t59 vss.t65 sg13_hv_nmos ad=0.34p pd=2.68u as=0.34p ps=2.68u w=1u l=1u
X40 x1.xamp.out1n x1.xamp.vbn1 vss.t59 vss.t77 sg13_hv_nmos ad=0.34p pd=2.68u as=0.34p ps=2.68u w=1u l=1u
X41 vss.t135 x1.x1[0].XM7.D0 x1.ena_b_h vss.t134 sg13_hv_nmos ad=0.34p pd=2.68u as=0.19p ps=1.38u w=1u l=0.5u
X42 vdd.t50 vdd.t50 vdd.t50 vdd.t6 sg13_hv_pmos ad=1.36p pd=8.68u as=0 ps=0 w=4u l=1u
X43 vss.t14 x1.level_shift_0[0].XM7.D0 x1.level_shift_0[0].out vss.t221 sg13_hv_nmos ad=0.34p pd=2.68u as=0.19p ps=1.38u w=1u l=0.5u
X44 x1.xres.XR1[6].R1 x1.xres.XR1[4].R2 vss.t9 rhigh l=20u w=0.69u
X45 vdd.t21 x1.xamp.XM6.S0 x1.xamp.XM8.S1 vdd.t6 sg13_hv_pmos ad=0.68p pd=4.68u as=0.68p ps=4.68u w=2u l=4u
X46 vss.t14 x1.level_shift_0[0].XM7.G0 x1.level_shift_0[0].XM7.D0 vss.t221 sg13_hv_nmos ad=0.34p pd=2.68u as=0.19p ps=1.38u w=1u l=0.5u
X47 x1.level_shift_0[3].XM7.G0 x1.level_shift_0[3].XM2.D0 vdd.t15 vdd.t0 sg13_hv_pmos ad=0.34p pd=2.68u as=0.19p ps=1.38u w=1u l=0.5u
X48 x2.diffb x2.vbp1 vdd.t252 vdd.t5 sg13_hv_pmos ad=0.34p pd=2.68u as=0.34p ps=2.68u w=1u l=1u
X49 x1.x1[3].out x1.x1[3].XM7.D0 vdd.t181 vdd.t0 sg13_hv_pmos ad=0.38p pd=2.38u as=0.38p ps=2.38u w=2u l=0.5u
X50 vss.t7 x1.x1[2].XM7.G0 x1.x1[2].XM7.D0 vss.t174 sg13_hv_nmos ad=0.34p pd=2.68u as=0.19p ps=1.38u w=1u l=0.5u
X51 x1.x1[1].XM7.G0 x1.x1[1].in_n vss.t242 vss.t269 sg13_hv_nmos ad=1.36p pd=8.68u as=0.76p ps=4.38u w=4u l=0.5u
X52 x1.xamp.out1n x1.xamp.vbn1 vss.t59 vss.t65 sg13_hv_nmos ad=0.34p pd=2.68u as=0.34p ps=2.68u w=1u l=1u
X53 vdd.t88 x1.level_shift_0[7].XM7.G0 x1.level_shift_0[7].XM7.D0 vdd.t0 sg13_hv_pmos ad=0.38p pd=2.38u as=0.68p ps=4.68u w=2u l=0.5u
X54 x1.xamp.out1p x1.xamp.vbn1 vss.t59 vss.t77 sg13_hv_nmos ad=0.34p pd=2.68u as=0.34p ps=2.68u w=1u l=1u
X55 x1.xamp.out1n x1.xres.d x1.xamp.XM1.S0 vdd.t6 sg13_hv_pmos ad=1.36p pd=8.68u as=1.36p ps=8.68u w=4u l=1u
X56 x2.XMB4.S0 x1.ena_b_h ibias2_1u vdd.t5 sg13_hv_pmos ad=0.34p pd=2.68u as=0.34p ps=2.68u w=1u l=4u
X57 vdd.t199 x1.level_shift_0[0].XM7.G0 x1.level_shift_0[0].XM2.D0 vdd.t0 sg13_hv_pmos ad=0.19p pd=1.38u as=0.34p ps=2.68u w=1u l=0.5u
X58 vdd.t27 x1.xamp.XM6.S0 x1.xamp.XM8.D0 vdd.t6 sg13_hv_pmos ad=0.68p pd=4.68u as=0.68p ps=4.68u w=2u l=4u
X59 x1.x1[4].out x1.x1[4].XM7.D0 vdd.t113 vdd.t0 sg13_hv_pmos ad=0.38p pd=2.38u as=0.38p ps=2.38u w=2u l=0.5u
X60 x1.level_shift_0[2].XM7.G0 x1.level_shift_0[2].XM2.D0 vdd.t219 vdd.t0 sg13_hv_pmos ad=0.34p pd=2.68u as=0.19p ps=1.38u w=1u l=0.5u
X61 x1.xamp.XM6.S0 x1.xamp.vbn2 x1.xamp.out1n vss.t181 sg13_hv_nmos ad=0.34p pd=2.68u as=0.34p ps=2.68u w=1u l=4u
X62 x2.outb1n.t8 x2.vbn2 x2.XM9.D0_0 vss.t318 sg13_hv_nmos ad=0.68p pd=4.68u as=0.68p ps=4.68u w=2u l=4u
X63 vss.t95 vss.t95 vss.t95 vss.t103 sg13_hv_nmos ad=0.34p pd=2.68u as=0 ps=0 w=1u l=1u
X64 x1.xtr.XM0[5].S x1.xtr.XM0[4].S vss.t0 rppd l=3.4u w=1.41u
X65 x1.xamp.out1n x1.xamp.vbn1 vss.t59 vss.t65 sg13_hv_nmos ad=0.34p pd=2.68u as=0.34p ps=2.68u w=1u l=1u
X66 x1.xamp.out1p x1.xamp.vbn1 vss.t59 vss.t77 sg13_hv_nmos ad=0.34p pd=2.68u as=0.34p ps=2.68u w=1u l=1u
X67 x2.outb1p.t35 x2.vbn1 vss.t95 vss.t424 sg13_hv_nmos ad=0.34p pd=2.68u as=0.34p ps=2.68u w=1u l=1u
X68 x1.level_shift_0[5].out x1.level_shift_0[5].XM7.D0 vdd.t194 vdd.t0 sg13_hv_pmos ad=0.38p pd=2.38u as=0.38p ps=2.38u w=2u l=0.5u
X69 x1.x1[4].out x1.x1[4].XM7.D0 vss.t171 vss.t170 sg13_hv_nmos ad=0.19p pd=1.38u as=0.34p ps=2.68u w=1u l=0.5u
X70 vss.t95 vss.t95 vss.t95 vss.t105 sg13_hv_nmos ad=0.34p pd=2.68u as=0 ps=0 w=1u l=1u
X71 x2.outb1n.t35 x2.vbn1 vss.t95 vss.t425 sg13_hv_nmos ad=0.34p pd=2.68u as=0.34p ps=2.68u w=1u l=1u
X72 vdd.t60 x1.x1[0].XM7.G0 x1.x1[0].XM7.D0 vdd.t0 sg13_hv_pmos ad=0.38p pd=2.38u as=0.68p ps=4.68u w=2u l=0.5u
X73 vdd.t86 x1.level_shift_0[7].XM7.D0 x1.level_shift_0[7].out vdd.t0 sg13_hv_pmos ad=0.68p pd=4.68u as=0.38p ps=2.38u w=2u l=0.5u
X74 x1.x1[6].XM7.G0 x1.x1[6].XM2.D0 vdd.t89 vdd.t0 sg13_hv_pmos ad=0.34p pd=2.68u as=0.19p ps=1.38u w=1u l=0.5u
X75 x1.xres.XR1[14].R1 x1.xres.XR1[16].R2 vss.t130 rhigh l=20u w=0.69u
X76 vdd.t3 x1.level_shift_0[5].XM7.G0 x1.level_shift_0[5].XM2.D0 vdd.t0 sg13_hv_pmos ad=0.19p pd=1.38u as=0.34p ps=2.68u w=1u l=0.5u
X77 x1.xtr.XM0[8].S x1.xtr.XM0[7].S vss.t0 rppd l=3.4u w=1.41u
X78 vdd.t98 x1.level_shift_0[1].XM7.G0 x1.level_shift_0[1].XM2.D0 vdd.t0 sg13_hv_pmos ad=0.19p pd=1.38u as=0.34p ps=2.68u w=1u l=0.5u
X79 vss.t7 x1.x1[3].in_n x1.x1[3].XM7.G0 vss.t163 sg13_hv_nmos ad=0.76p pd=4.38u as=1.36p ps=8.68u w=4u l=0.5u
X80 vss.t120 vss.t111 vss.t119 vss.t118 sg13_hv_nmos ad=0.34p pd=2.68u as=0 ps=0 w=1u l=1u
X81 vss.t59 vss.t59 vss.t59 vss.t75 sg13_hv_nmos ad=0.34p pd=2.68u as=0 ps=0 w=1u l=1u
X82 x2.outa1p.t13 x2.outa1n.t52 vdd.t5 vdd.t5 sg13_hv_pmos ad=0.34p pd=2.68u as=0.34p ps=2.68u w=1u l=1u
X83 x2.XM9.D0_0 x2.XM9.D0_0 x2.outa1n.t35 vdd.t5 sg13_hv_pmos ad=0.34p pd=2.68u as=0.34p ps=2.68u w=1u l=4u
X84 x2.vbp1 x2.vbp1 vdd.t252 vdd.t5 sg13_hv_pmos ad=0.34p pd=2.68u as=0.34p ps=2.68u w=1u l=1u
X85 vss.t135 trim[15] x1.x1[1].XM2.D0 vss.t250 sg13_hv_nmos ad=0.76p pd=4.38u as=1.36p ps=8.68u w=4u l=0.5u
X86 vss.t59 vss.t59 vss.t59 vss.t60 sg13_hv_nmos ad=0.34p pd=2.68u as=0 ps=0 w=1u l=1u
X87 x1.level_shift_0[6].out x1.level_shift_0[6].XM7.D0 vdd.t111 vdd.t0 sg13_hv_pmos ad=0.38p pd=2.38u as=0.38p ps=2.38u w=2u l=0.5u
X88 x2.outa1n.t17 x2.outa1n.t16 vdd.t5 vdd.t5 sg13_hv_pmos ad=0.34p pd=2.68u as=0.34p ps=2.68u w=1u l=1u
X89 x1.x1[0].XM7.D0 x1.x1[0].XM7.G0 vss.t135 vss.t137 sg13_hv_nmos ad=0.19p pd=1.38u as=0.34p ps=2.68u w=1u l=0.5u
X90 x1.x1[5].out x1.x1[5].XM7.D0 vss.t11 vss.t248 sg13_hv_nmos ad=0.19p pd=1.38u as=0.34p ps=2.68u w=1u l=0.5u
X91 x1.level_shift_0[5].out x1.level_shift_0[5].XM7.D0 vss.t271 vss.t124 sg13_hv_nmos ad=0.19p pd=1.38u as=0.34p ps=2.68u w=1u l=0.5u
X92 x1.XM1.G0 x1.xamp.vbp2 x1.xamp.XM8.D0 vdd.t6 sg13_hv_pmos ad=0.68p pd=4.68u as=0.68p ps=4.68u w=2u l=4u
X93 x2.outa1n.t5 x2.outa1n.t4 vdd.t112 vdd.t5 sg13_hv_pmos ad=0.34p pd=2.68u as=0.34p ps=2.68u w=1u l=1u
X94 x1.xamp.XM1.S0 x1.xamp.vbp1 vdd.t6 vdd.t6 sg13_hv_pmos ad=0.34p pd=2.68u as=0.34p ps=2.68u w=1u l=1u
X95 x1.level_shift_0[5].XM7.D0 x1.level_shift_0[5].XM7.G0 vss.t271 vss.t131 sg13_hv_nmos ad=0.19p pd=1.38u as=0.34p ps=2.68u w=1u l=0.5u
X96 x2.outb1p.t18 x2.vbn2 x2.XMOP.G0_0 vss.t321 sg13_hv_nmos ad=0.68p pd=4.68u as=0.68p ps=4.68u w=2u l=4u
X97 x2.outa1p.t14 x2.outa1n.t57 vdd.t112 vdd.t5 sg13_hv_pmos ad=0.34p pd=2.68u as=0.34p ps=2.68u w=1u l=1u
X98 x1.x1[7].XM7.D0 x1.x1[7].XM7.G0 vss.t155 vss.t355 sg13_hv_nmos ad=0.19p pd=1.38u as=0.34p ps=2.68u w=1u l=0.5u
X99 x2.outb1n.t5 x2.vbn2 x2.XM9.D0_0 vss.t309 sg13_hv_nmos ad=0.68p pd=4.68u as=0.68p ps=4.68u w=2u l=4u
X100 x2.outb1p.t36 x2.vbn1 vss.t120 vss.t404 sg13_hv_nmos ad=0.34p pd=2.68u as=0.34p ps=2.68u w=1u l=1u
X101 x1.x1[8].XM7.G0 x1.x1[8].in_n vss.t18 vss.t17 sg13_hv_nmos ad=1.36p pd=8.68u as=0.76p ps=4.38u w=4u l=0.5u
X102 vss.t242 trim[13] x1.x1[2].XM2.D0 vss.t290 sg13_hv_nmos ad=0.76p pd=4.38u as=1.36p ps=8.68u w=4u l=0.5u
X103 vss.t31 x1.level_shift_0[2].XM7.D0 x1.level_shift_0[2].out vss.t342 sg13_hv_nmos ad=0.34p pd=2.68u as=0.19p ps=1.38u w=1u l=0.5u
X104 vdd.t12 x1.level_shift_0[7].XM7.G0 x1.level_shift_0[7].XM2.D0 vdd.t0 sg13_hv_pmos ad=0.19p pd=1.38u as=0.34p ps=2.68u w=1u l=0.5u
X105 x1.xamp.XM6.S0 x1.xamp.vbn2 x1.xamp.out1n vss.t180 sg13_hv_nmos ad=0.34p pd=2.68u as=0.34p ps=2.68u w=1u l=4u
X106 vdd.t133 x1.x1[2].XM7.G0 x1.x1[2].XM7.D0 vdd.t0 sg13_hv_pmos ad=0.38p pd=2.38u as=0.68p ps=4.68u w=2u l=0.5u
X107 vdd.t50 vdd.t50 vdd.t50 vdd.t6 sg13_hv_pmos ad=1.36p pd=8.68u as=0 ps=0 w=4u l=1u
X108 vss.t18 x1.x1[8].XM7.D0 x1.x1[8].out vss.t295 sg13_hv_nmos ad=0.34p pd=2.68u as=0.19p ps=1.38u w=1u l=0.5u
X109 x1.level_shift_0[4].XM7.G0 x1.level_shift_0[4].XM2.D0 vdd.t1 vdd.t0 sg13_hv_pmos ad=0.34p pd=2.68u as=0.19p ps=1.38u w=1u l=0.5u
X110 x1.x1[1].XM7.D0 x1.x1[1].XM7.G0 vss.t242 vss.t243 sg13_hv_nmos ad=0.19p pd=1.38u as=0.34p ps=2.68u w=1u l=0.5u
X111 x2.diffa x2.vbn1 vss.t95 vss.t107 sg13_hv_nmos ad=0.34p pd=2.68u as=0.34p ps=2.68u w=1u l=1u
X112 x2.outa1p.t24 x2.XM9.D0_0 x2.XMOP.G0_0 vdd.t5 sg13_hv_pmos ad=0.34p pd=2.68u as=0.34p ps=2.68u w=1u l=4u
X113 x1.xamp.XM6.S0 x1.xamp.vbp2 x1.xamp.XM8.S1 vdd.t6 sg13_hv_pmos ad=0.68p pd=4.68u as=0.68p ps=4.68u w=2u l=4u
X114 x1.level_shift_0[2].out x1.level_shift_0[2].XM7.D0 vdd.t232 vdd.t0 sg13_hv_pmos ad=0.38p pd=2.38u as=0.38p ps=2.38u w=2u l=0.5u
X115 x1.x1[2].XM7.G0 x1.x1[2].in_n vss.t177 vss.t235 sg13_hv_nmos ad=1.36p pd=8.68u as=0.76p ps=4.38u w=4u l=0.5u
X116 x2.outb1n.t7 x2.vbn2 x2.XM9.D0_0 vss.t313 sg13_hv_nmos ad=0.68p pd=4.68u as=0.68p ps=4.68u w=2u l=4u
X117 x1.xamp.out1p x1.xres.c x1.xamp.XM1.S0 vdd.t6 sg13_hv_pmos ad=1.36p pd=8.68u as=1.36p ps=8.68u w=4u l=1u
X118 vss.t259 x1.level_shift_0[1].in_n x1.level_shift_0[1].XM7.G0 vss.t377 sg13_hv_nmos ad=0.76p pd=4.38u as=1.36p ps=8.68u w=4u l=0.5u
X119 vdd.t16 x1.level_shift_0[3].XM7.G0 x1.level_shift_0[3].XM2.D0 vdd.t0 sg13_hv_pmos ad=0.19p pd=1.38u as=0.34p ps=2.68u w=1u l=0.5u
X120 vss.t7 x1.x1[2].XM7.D0 x1.x1[2].out vss.t174 sg13_hv_nmos ad=0.34p pd=2.68u as=0.19p ps=1.38u w=1u l=0.5u
X121 x1.x1[0].XM2.D0 x1.x1[0].in_p vss.t380 vss.t379 sg13_hv_nmos ad=1.36p pd=8.68u as=0.76p ps=4.38u w=4u l=0.5u
X122 vss.t11 x1.x1[5].in_n x1.x1[5].XM7.G0 vss.t232 sg13_hv_nmos ad=0.76p pd=4.38u as=1.36p ps=8.68u w=4u l=0.5u
X123 vdd.t94 x1.level_shift_0[3].XM7.D0 x1.level_shift_0[3].out vdd.t0 sg13_hv_pmos ad=0.68p pd=4.68u as=0.38p ps=2.38u w=2u l=0.5u
X124 vss.t125 x1.level_shift_0[4].XM7.D0 x1.level_shift_0[4].out vss.t124 sg13_hv_nmos ad=0.34p pd=2.68u as=0.19p ps=1.38u w=1u l=0.5u
X125 vdd.t131 x1.x1[2].XM7.D0 x1.x1[2].out vdd.t0 sg13_hv_pmos ad=0.68p pd=4.68u as=0.38p ps=2.38u w=2u l=0.5u
X126 vss.t125 x1.level_shift_0[4].XM7.G0 x1.level_shift_0[4].XM7.D0 vss.t131 sg13_hv_nmos ad=0.34p pd=2.68u as=0.19p ps=1.38u w=1u l=0.5u
X127 vss.t59 vss.t59 vss.t59 vss.t77 sg13_hv_nmos ad=0.34p pd=2.68u as=0 ps=0 w=1u l=1u
X128 x2.outb1n.t40 x2.vbn1 vss.t391 vss.t412 sg13_hv_nmos ad=0.34p pd=2.68u as=0.34p ps=2.68u w=1u l=1u
X129 x2.diffb x2.vbp1 vdd.t252 vdd.t5 sg13_hv_pmos ad=0.34p pd=2.68u as=0.34p ps=2.68u w=1u l=1u
X130 x2.outb1p.t14 x2.vbn2 x2.XMOP.G0_0 vss.t312 sg13_hv_nmos ad=0.68p pd=4.68u as=0.68p ps=4.68u w=2u l=4u
X131 x2.vbn1 x2.vbn1 vss.t111 vss.t400 sg13_hv_nmos ad=0.34p pd=2.68u as=0.34p ps=2.68u w=1u l=1u
X132 vss.t111 vss.t111 vss.t111 vss.t112 sg13_hv_nmos ad=0.34p pd=2.68u as=0 ps=0 w=1u l=1u
X133 x2.vbn1 x2.vbn1 vss.t115 vss.t401 sg13_hv_nmos ad=0.34p pd=2.68u as=0.34p ps=2.68u w=1u l=1u
X134 x2.outa1n.t13 x2.outa1n.t12 vdd.t5 vdd.t5 sg13_hv_pmos ad=0.34p pd=2.68u as=0.34p ps=2.68u w=1u l=1u
X135 x2.vbn2 x2.vbp1 vdd.t252 vdd.t5 sg13_hv_pmos ad=0.34p pd=2.68u as=0.34p ps=2.68u w=1u l=1u
X136 vdd.t23 x1.xamp.XM6.S0 x1.xamp.XM8.S1 vdd.t6 sg13_hv_pmos ad=0.68p pd=4.68u as=0.68p ps=4.68u w=2u l=4u
X137 x2.outa1p.t12 x2.outa1n.t53 vdd.t5 vdd.t5 sg13_hv_pmos ad=0.34p pd=2.68u as=0.34p ps=2.68u w=1u l=1u
X138 x1.level_shift_0[6].XM7.G0 x1.level_shift_0[6].XM2.D0 vdd.t171 vdd.t0 sg13_hv_pmos ad=0.34p pd=2.68u as=0.19p ps=1.38u w=1u l=0.5u
X139 x2.diffa vbg.t8 x2.outa1n.t47 vss.t353 sg13_hv_nmos ad=0.68p pd=4.68u as=0.68p ps=4.68u w=2u l=1u
X140 x1.xamp.vbn2 x1.xamp.vbp1 vdd.t6 vdd.t6 sg13_hv_pmos ad=0.34p pd=2.68u as=0.34p ps=2.68u w=1u l=1u
X141 x2.outa1p.t11 x2.outa1n.t59 vdd.t121 vdd.t5 sg13_hv_pmos ad=0.34p pd=2.68u as=0.34p ps=2.68u w=1u l=1u
X142 vss.t14 trim[14] x1.level_shift_0[0].XM2.D0 vss.t15 sg13_hv_nmos ad=0.76p pd=4.38u as=1.36p ps=8.68u w=4u l=0.5u
X143 x2.diffb x2.vbp1 vdd.t252 vdd.t5 sg13_hv_pmos ad=0.34p pd=2.68u as=0.34p ps=2.68u w=1u l=1u
X144 vdd.t179 x1.x1[3].XM7.D0 x1.x1[3].out vdd.t0 sg13_hv_pmos ad=0.68p pd=4.68u as=0.38p ps=2.38u w=2u l=0.5u
X145 x2.diffb x2.vbp1 vdd.t252 vdd.t5 sg13_hv_pmos ad=0.34p pd=2.68u as=0.34p ps=2.68u w=1u l=1u
X146 x1.x1[0].XM7.G0 x1.x1[0].XM2.D0 vdd.t152 vdd.t0 sg13_hv_pmos ad=0.34p pd=2.68u as=0.19p ps=1.38u w=1u l=0.5u
X147 vdd.t114 x1.x1[4].XM7.G0 x1.x1[4].XM7.D0 vdd.t0 sg13_hv_pmos ad=0.38p pd=2.38u as=0.68p ps=4.68u w=2u l=0.5u
X148 x1.xamp.XM1.S0 x1.xamp.vbp1 vdd.t50 vdd.t6 sg13_hv_pmos ad=0.34p pd=2.68u as=0.34p ps=2.68u w=1u l=1u
X149 vdd.t126 x1.x1[3].XM7.G0 x1.x1[3].XM2.D0 vdd.t0 sg13_hv_pmos ad=0.19p pd=1.38u as=0.34p ps=2.68u w=1u l=0.5u
X150 x1.xres.XR1[5].R1 x1.xres.XR1[3].R2 vss.t1 rhigh l=20u w=0.69u
X151 x1.level_shift_0[0].XM7.G0 x1.level_shift_0[0].in_n vss.t14 vss.t291 sg13_hv_nmos ad=1.36p pd=8.68u as=0.76p ps=4.38u w=4u l=0.5u
X152 x2.vbp1 x2.vbp1 vdd.t121 vdd.t5 sg13_hv_pmos ad=0.34p pd=2.68u as=0.34p ps=2.68u w=1u l=1u
X153 x1.ena_b_h x1.x1[0].XM7.D0 vss.t135 vss.t137 sg13_hv_nmos ad=0.19p pd=1.38u as=0.34p ps=2.68u w=1u l=0.5u
X154 x1.x1[4].XM7.G0 x1.x1[4].in_n vss.t171 vss.t293 sg13_hv_nmos ad=1.36p pd=8.68u as=0.76p ps=4.38u w=4u l=0.5u
X155 x2.diffa x2.vbn1 vss.t95 vss.t99 sg13_hv_nmos ad=0.34p pd=2.68u as=0.34p ps=2.68u w=1u l=1u
X156 vss.t14 trim[12] x1.level_shift_0[1].XM2.D0 vss.t268 sg13_hv_nmos ad=0.76p pd=4.38u as=1.36p ps=8.68u w=4u l=0.5u
X157 x1.x1[8].XM7.D0 x1.x1[8].XM7.G0 vss.t18 vss.t296 sg13_hv_nmos ad=0.19p pd=1.38u as=0.34p ps=2.68u w=1u l=0.5u
X158 vss.t155 x1.x1[7].in_n x1.x1[7].XM7.G0 vss.t375 sg13_hv_nmos ad=0.76p pd=4.38u as=1.36p ps=8.68u w=4u l=0.5u
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
