RTimothyEdwards/sg13cmos5l_ocd_ip__biasgen/(commit log)

2026-03-28 The designs in this library are still in an unfinished state but are close enough to be worth pushing everything now. All three designs (bandgap, current bias generator, and voltage bias generator) a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
    [bandgap_amp.sch, bandgap_tb.sch, bandgap_unbuffered.sch, bg_res.sch, bg_trim.sch, bias_amp.sch, bias_amp_large.sch, bias_gen_fe_tb.sch]
2026-03-28 Finished subcircuit layouts which are now DRC clean (in magic) and LVS clean (magic/netgen) for all three cells (bandgap, voltage bias generator, and current bias generator).
    [bias_amp_large.sch, bias_generator_be0n.sch, bias_generator_be0p.sch, bias_generator_be1n.sch, bias_generator_be1p.sch, bias_generator_fe.sch, bias_nset.sch, bias_nstack.sch]
2026-03-29 Additional changes after running klayout DRC; mainly, the level shifters need to be completely covered by the thick oxide mask, and also both the voltage bias generator and bandgap cells were overlay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
2026-03-31 Fixed a signal naming discrepancy between schematic and layout in the bandgap, "ctl" vs. "ctrl" for the digital control pins.
    [bg_trim.sch]
2026-04-06 Updates, mainly in documentation.
    Added datasheets for the three main blocks, which are the
    bandgap, the current bias generator, and the voltage bias
    generator. Also updated the bandgap testbench to make it easier
    to set the trim value.
    [bandgap_tb.sch]
2026-08-31 Updates to the biagen library for the next IHP shuttle run. Changes include doubling the capacitor sizes (because the sidewall values were incorrectly computed in the tech file, making the devices 2x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
    [bandgap_unbuffered_v2.sch, bias_generator_be0p_v2.sch, bias_generator_ben1um.sch, bias_generator_ben250nm.sch, bias_generator_fe_v2.sch, se_folded_cascode_np_ab.sch, sg13cmos5l_ocd_ip__bandgap_v2.sch, sg13cmos5l_ocd_ip__biasgen2.sch]
2026-09-04 Modified the bias generator block for the Chipalooza harness chip to remove metal 5, because the cell will sit in a spot that is critical for routing power.
2026-09-21 Corrected the bandgap design, which was using the wrong resistor type (rhigh) for the trim resistor chain. Changing the resistor type to rppd without any other changes to the bandgap places the flatt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
    [bandgap_tc_tb.sch, bandgap_unbuffered.sch, bg_trim.sch, sg13cmos5l_ocd_ip__bandgap_v3.sch]
2026-09-21 One more thing: Added the temperature coefficient ranges (max - min) that were measured in simulation (35.78 ppm/deg. C for the full temperature range -40 to 125 C) to the bandgap document.
2026-09-22 Updated all of the schematics and layout to use the IHP "cap_cmomf" device model. This required some changes to the IHP PDK (which have been posted as a pull request) and changing the schematics to s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
    [bandgap_unbuffered.sch, bandgap_unbuffered_v2.sch, bias_generator_fe.sch, bias_generator_fe_v2.sch, se_folded_cascode_np_ab.sch, sg13cmos5l_ocd_ip__voltgen.sch, sg13cmos5l_ocd_ip__voltgen_v2.sch]
2026-09-25 Added CACE templates and testbenches and generated a preliminary (but incomplete) CACE spec document.
    [bandgap_curve_tb.sch, bandgap_psrr.sch, bandgap_tb.sch, bandgap_tc_tb.sch, bandgap_trim_tc_tb.sch]
2026-10-06 Did a bit of an overhaul of the bandgap and voltage bias generator circuits. Found that the amplifiers were compressing the voltage headroom on the ibias lines because of the added enable switch. Sin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
    [bandgap_linereg_tb.sch, bandgap_psrr_tb.sch, bandgap_unbuffered.sch, bandgap_unbuffered_v2.sch, bias_generator_ben4um.sch, se_folded_cascode_np_ab.sch, se_folded_cascode_p.sch, sg13cmos5l_ocd_ip__bandgap_v2.sch]
2026-10-07 Corrected the xschem testbenches to add the capacitor library to the list of includes; the previous version worked with my interim caps that were unmodeled.
    [bandgap_tb.sch, bandgap_tc_tb.sch]
2026-10-11 A few additional changes to schematics; the result is now satisfactory and ready to go to layout.
2026-11-09 Corrected a DRC error again because I previously corrected an older version of the cell that was not being used currently.
